EEST1/Entrenador4to2018/Documentación/2020/Principal.tex

\documentclass[a4paper,spanish]{article}
\usepackage{lmodern}
\renewcommand{\familydefault}{\sfdefault}
\usepackage[T1]{fontenc}
\usepackage[utf8]{inputenc}
\usepackage[spanish]{babel}
\setcounter{secnumdepth}{4}
\setcounter{tocdepth}{4}
\usepackage{array}
\usepackage{float}
\usepackage{fancybox}
\usepackage{calc}
\usepackage{units}
\usepackage{textcomp}
\usepackage{multirow}
\usepackage{amsmath}
\usepackage{amssymb}
\usepackage{graphicx}
\usepackage{nomencl}
\usepackage{fancyhdr}
\usepackage{graphics}
\usepackage{circuitikz}
\usepackage{pgf,tikz}
\usepackage{multicol,caption}
\usepackage{mathtools}
\usepackage[makeroom]{cancel}
\usepackage{lscape}
\usepackage{rotating}
\usepackage{lastpage}
\usepackage{titlesec}
\usepackage[margin=1in,headsep=1cm,headheight= 1in,top=1.5in]{geometry}
\usetikzlibrary{arrows}
\usetikzlibrary{shapes.symbols}
\usetikzlibrary{shapes.arrows}
\usetikzlibrary{calc,intersections,through,backgrounds}
\usetikzlibrary{patterns}
\PassOptionsToPackage{caption=false}{subfig}
\usepackage{subfig}
\makeatother
\graphicspath{ {imagenes/} }
\newtheorem{ej}{{Ejemplo }}[section]
\pagestyle{fancy}

\titleformat{name=\section}[block]
{\sffamily\bfseries\Large}
{}
{0pt}
{\colorsection}
\titlespacing*{\section}{0pt}{\baselineskip}{\baselineskip}

\newcommand{\colorsection}[1]{%
	\colorbox{teal!50}{\parbox{\dimexpr\textwidth-2\fboxsep}{\thesection\ #1}}}

\begin{document}

	\begin{tikzpicture}[remember picture, overlay]
	\node[at=(current page.center)](){};
	\node[overlay,anchor=south,yshift=4.5cm,fill=white](aplicaciones)at(current page.south)[]{\fontsize{40}{60} \textbf{ENTRENADOR DIGITAL}}		
	;
	%\node[below of=aplicaciones,yshift=-1 cm,fill=white](jaja){\fontsize{40}{50}\textbf{\emph{Profesor Esteban Lemos}}};
	\end{tikzpicture}
\clearpage
	%Indice automático
\fancyhead{}
\fancyhead[C]{ÍNDICE}

\tableofcontents{}
\clearpage
	%formato del resto del documento
\fancyhead{}

\rhead{\leftmark\\\rightmark}

\renewcommand{\footrulewidth}{2pt}
\renewcommand{\headrulewidth}{2pt}

\rfoot{\thepage\ of \pageref{LastPage}}
\fancyhead{}
\cfoot{\footnotesize\textbf{ Escuela de Educación Secundaria Técnica N$^\circ$ 1 - Vicente López}\\Cerrito N$^\circ$ 3966 (1605) Villa Adelina, Partido de Vicente López.\\Tel:(011) 47350174 -- email: tecnica1vl@gmail.com}

\lhead{\begin{tikzpicture}
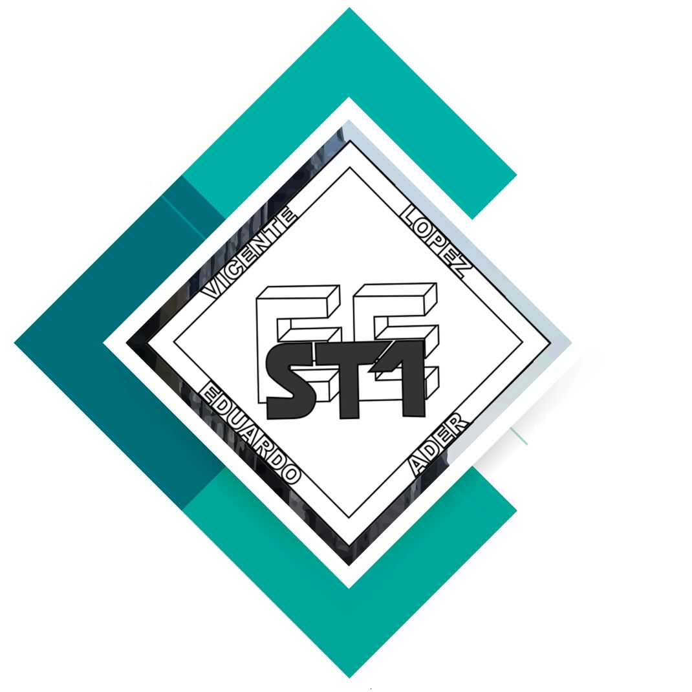
[picture p1: Documentación/2020/imagenes/logo2.jpg]
	\node (0,0)[]{};
	\node [text width=8cm,align=left,xshift=5cm] at (0,0){\textbf{Plan de Trabajo 2019}\linebreak Jefatura de Área\linebreak E.E.S.T. N$^\circ$ 1 V.L.} ;
	\end{tikzpicture}
}
\rhead{\leftmark\\\rightmark}

	%Contenidos
\include{Introduccion}	
\include{Armado}

%\include{PuestaEnMarcha}
%\include{Practicas}

\end{document}
