EEST1/Entrenador4to2018/Documentación/2020/imagenes/PosterBase-eps-converted-to.pdf

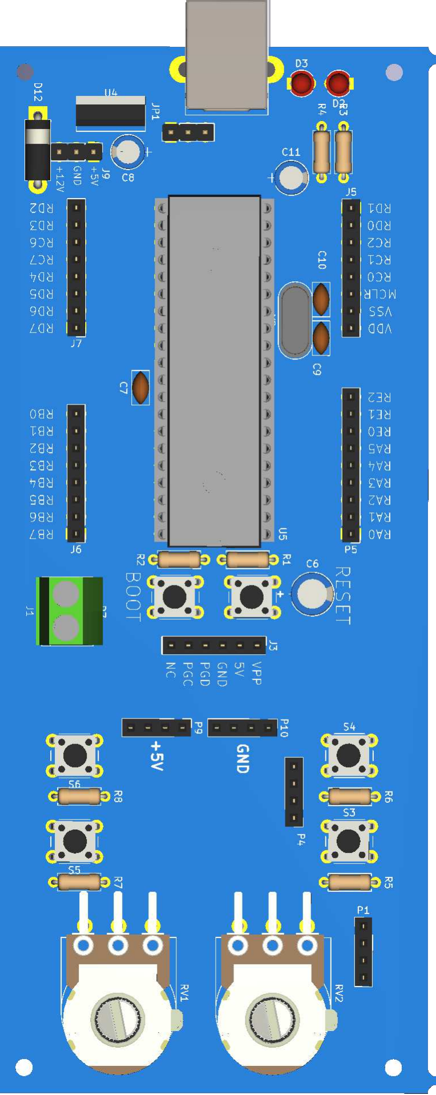
[picture p2: page 1]
