EEST1/Entrenador4to2018/Documentación/2020/imagenes/PosterBase.pdf

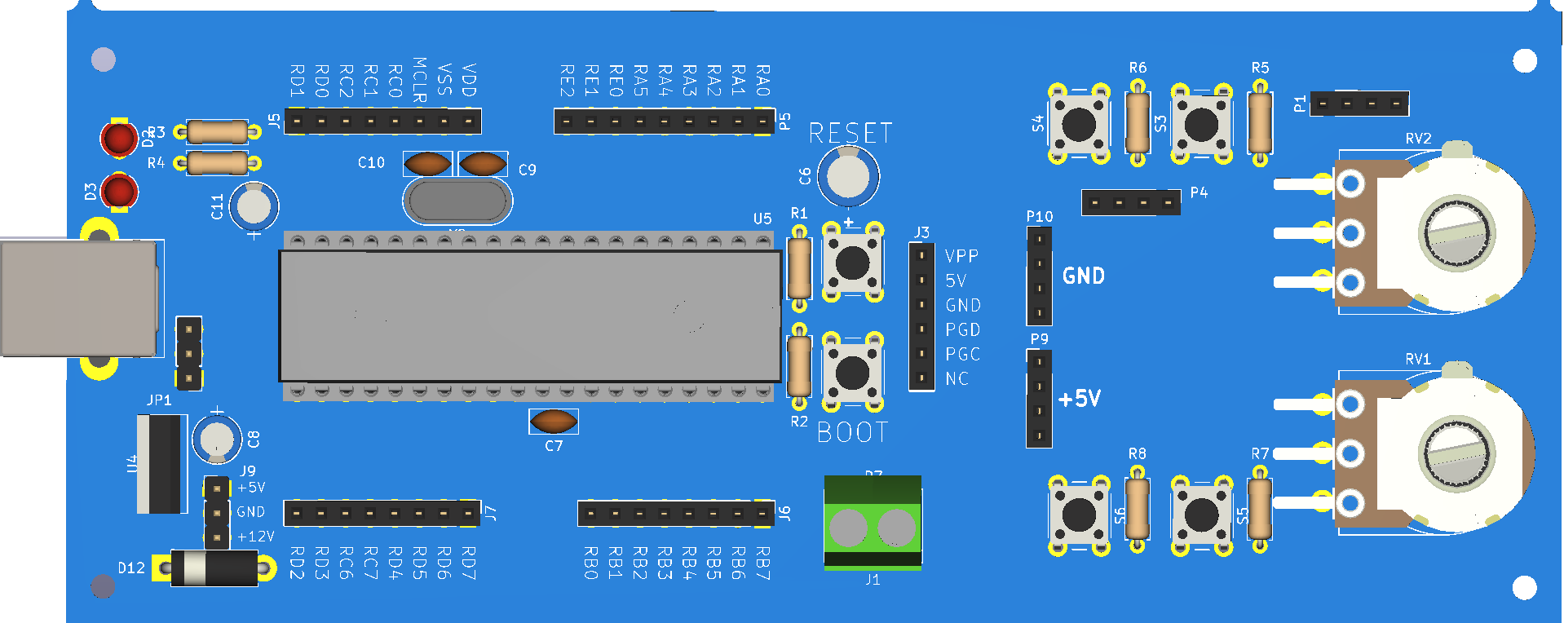
[picture p3: page 1]
