EEST1/Entrenador4to2018/Documentación/Gabinete.pdf

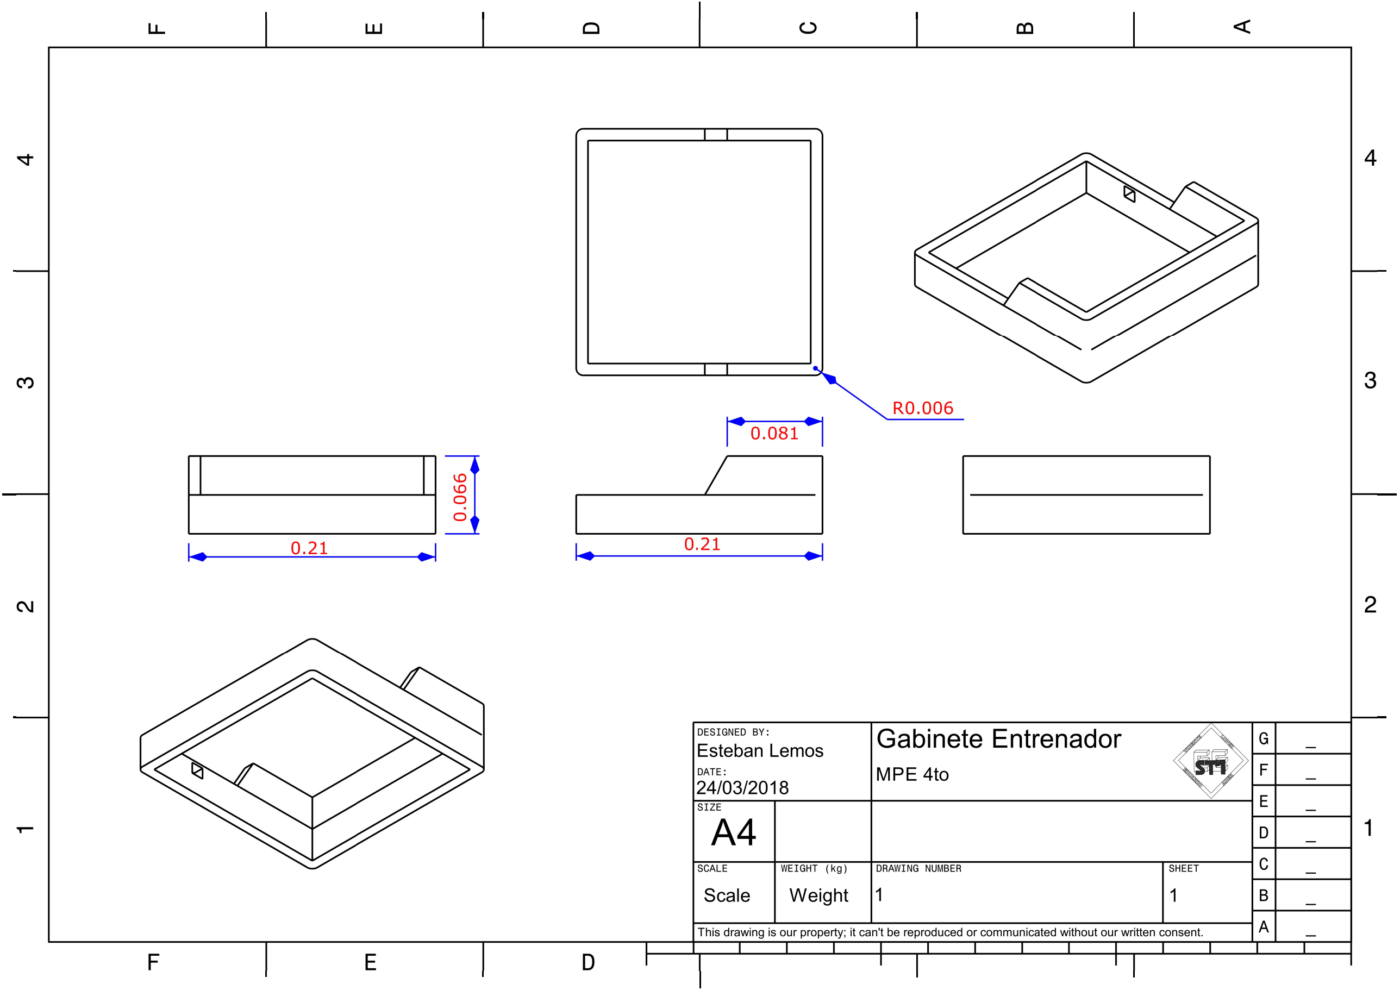
[picture p4: page 1]
