EEST1/Entrenador4to2018/Documentación/2020/imagenes/Esquematico.png

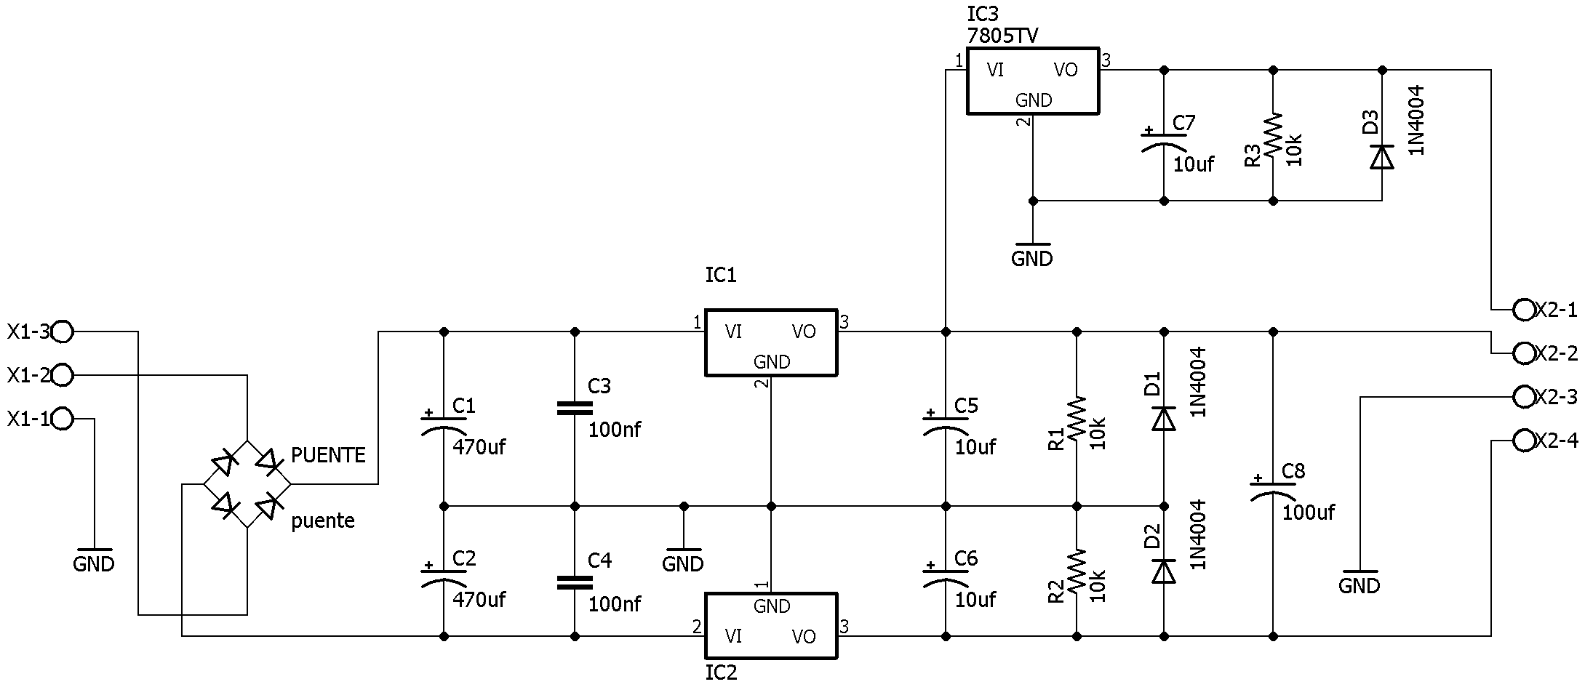
Documentación/2020/imagenes/Esquematico.png
