EEST1/Entrenador4to2018/Documentación/2020/imagenes/GabineteRender2.jpg

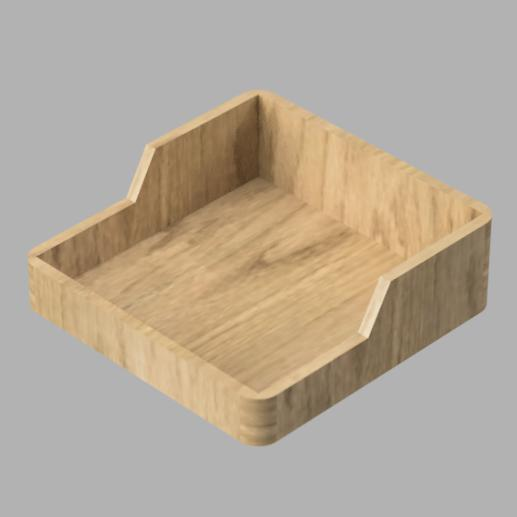
Documentación/2020/imagenes/GabineteRender2.jpg
