EEST1/Entrenador4to2018/Documentación/2020/imagenes/PosterCompletoEntrenador_2.png

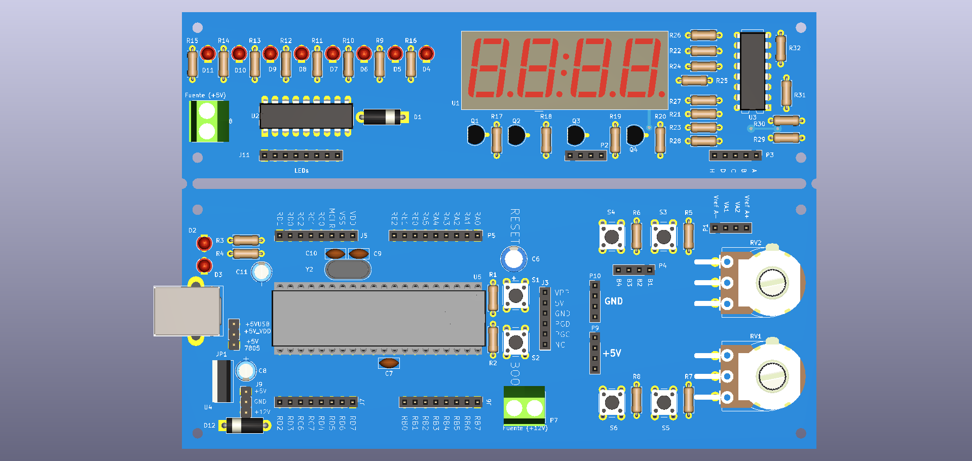
Documentación/2020/imagenes/PosterCompletoEntrenador_2.png
