EEST1/Entrenador4to2018/Documentación/Entrenador1-SchDoc_4Display_en_uno v13.jpg

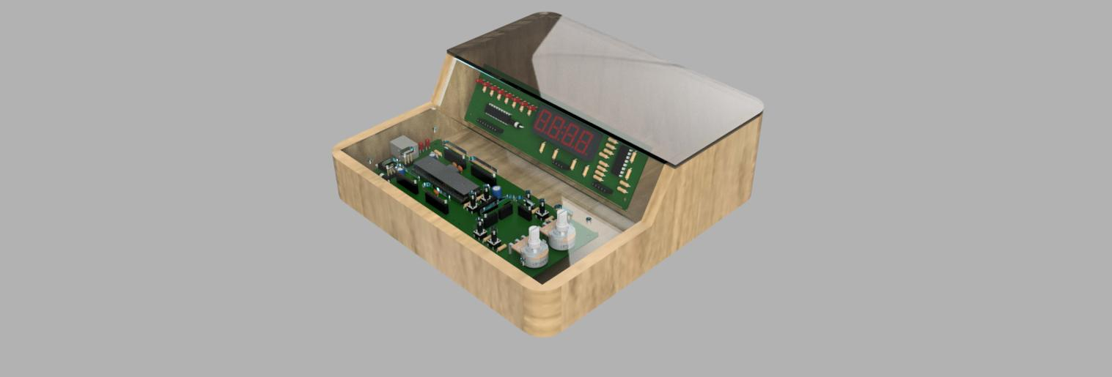
Documentación/Entrenador1-SchDoc_4Display_en_uno v13.jpg
