EEST1/Entrenador4to2018/Documentación/Entrenador1-SchDoc_4Display_en_uno v14.png

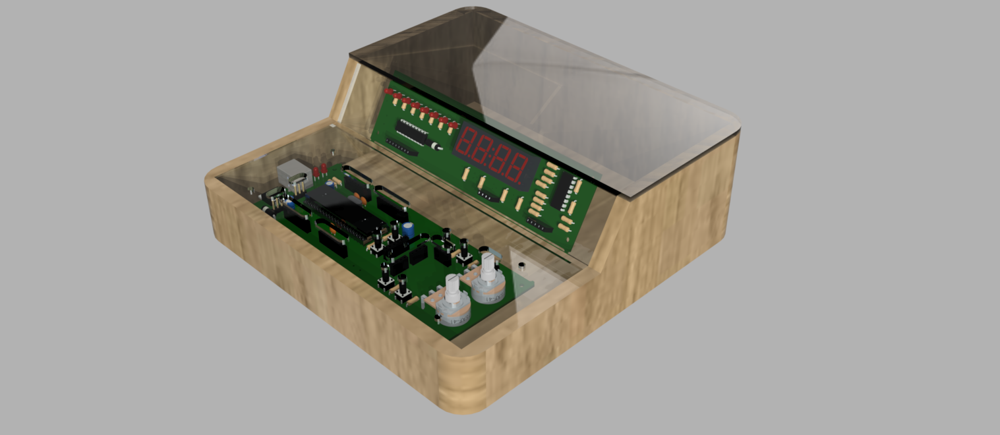
Documentación/Entrenador1-SchDoc_4Display_en_uno v14.png
