EEST1/Entrenador4to2018/Documentación/Entrenador1-SchDoc_4Display_en_uno_2020-Jan-02_07-53-40PM-000_CustomizedView2626504624_png_alpha.png

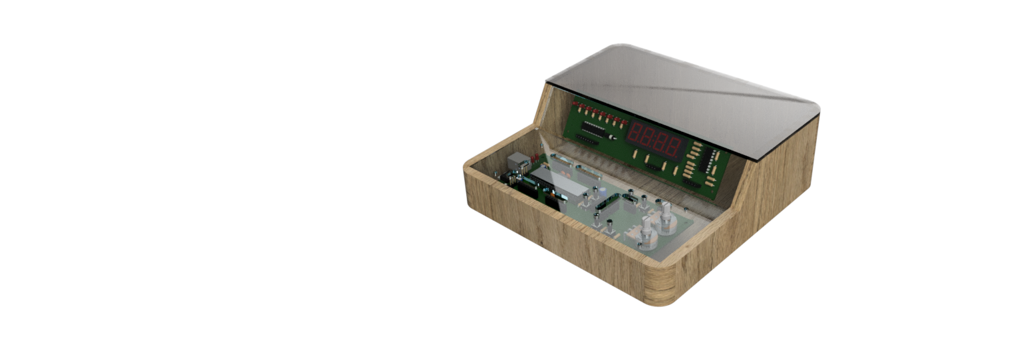
Documentación/Entrenador1-SchDoc_4Display_en_uno_2020-Jan-02_07-53-40PM-000_CustomizedView2626504624_png_alpha.png
