EEST1/Entrenador4to2018/Documentación/FB_IMG_1604214108332.jpg

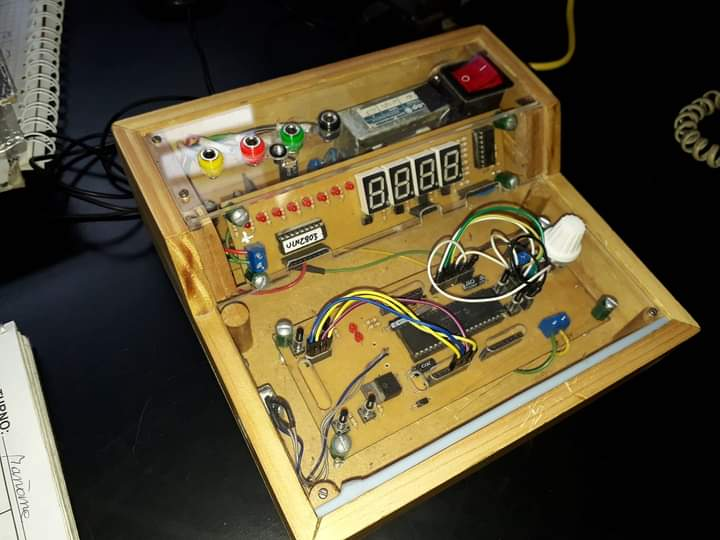
Documentación/FB_IMG_1604214108332.jpg
