EEST1/Entrenador4to2018/Modelos3d/4-different-switches-1.snapshot.2/untitled.165.jpg

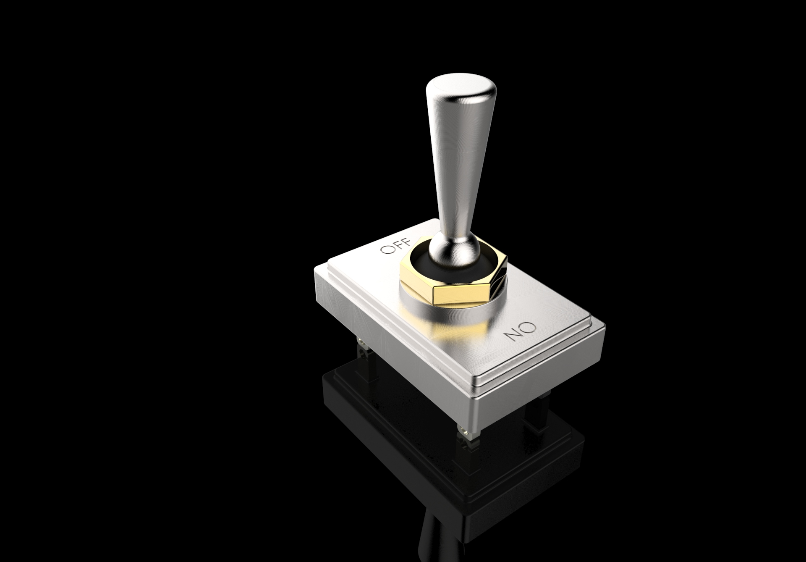
Modelos3d/4-different-switches-1.snapshot.2/untitled.165.jpg
