EEST1/Entrenador4to2018/Modelos3d/fuse-holder-8.snapshot.4/2017-11-11_21-51-52.jpg

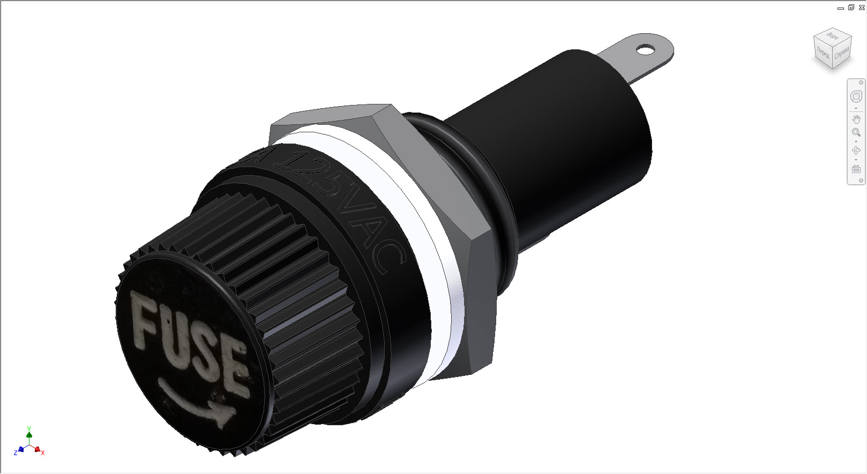
Modelos3d/fuse-holder-8.snapshot.4/2017-11-11_21-51-52.jpg
