EEST1/Entrenador4to2018/Modelos3d/fuse-holder-8.snapshot.4/IMG_20171111_112237.jpg

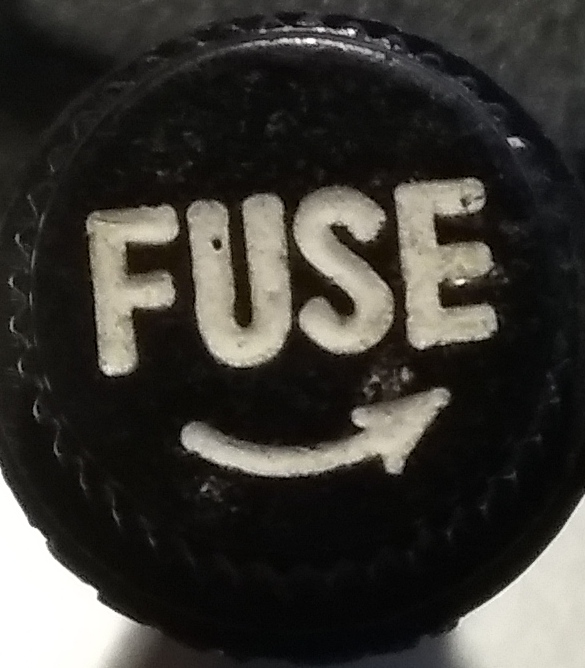
Modelos3d/fuse-holder-8.snapshot.4/IMG_20171111_112237.jpg
