EEST1/Entrenador4to2018/Modelos3d/hirschmann-pki-10-a-banana-plug-1.snapshot.2/Hirschmann PKI 10 A Banana plug v15.png

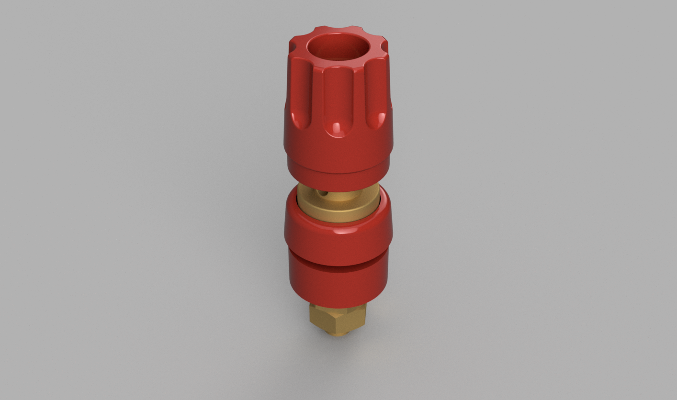
Modelos3d/hirschmann-pki-10-a-banana-plug-1.snapshot.2/Hirschmann PKI 10 A Banana plug v15.png
