EEST1/Entrenador4to2018/Documentación/Lista_Materiales.ods

Id | Cantidad | Identificador | Empaquetado | Identificación
1 | 1 | P6 | USB_B | USB_B
2 | 2 | P7,P8 | TerminalBlock_Altech_AK300-2_P5.00mm | CONN_01X02
3 | 1 | P5 | Socket_Strip_Straight_1x09_Pitch2.54mm | CONN_01X09
4 | 1 | JP1 | Pin_Header_Straight_1x03_Pitch2.54mm | JUMPER3
5 | 2 | D12,D1 | D_5W_P10.16mm_Horizontal | 1n4004
6 | 1 | J9 | Pin_Header_Straight_1x03_Pitch2.54mm | 3vias
7 | 5 | P1,P4,P9,P10,P2 | Socket_Strip_Straight_1x04_Pitch2.54mm | CONN_01X04
8 | 1 | Y2 | Crystal_HC49-4H_Vertical | 20MHz
9 | 2 | C10,C9 | C_Disc_D5.0mm_W2.5mm_P2.50mm | 22pf
10 | 1 | C8 | CP_Radial_D5.0mm_P2.50mm | 47uf
11 | 1 | C11 | CP_Radial_D5.0mm_P2.50mm | 1uf
12 | 1 | C6 | CP_Radial_D6.3mm_P2.50mm | 10uf
13 | 1 | J3 | Socket_Strip_Straight_1x06_Pitch2.54mm | ICSP
14 | 6 | S1,S2,S6,S5,S4,S3 | SW_PUSH_6mm_h13mm | SW DPST_2
15 | 10 | D11,D3,D2,D10,D9,D8,D7,D6,D5,D4 | LED_D3.0mm | LED
16 | 4 | J11,J5,J6,J7 | Socket_Strip_Straight_1x08_Pitch2.54mm | CON8
17 | 6 | R8,R2,R1,R7,R5,R6 | R_Axial_DIN0207_L6.3mm_D2.5mm_P7.62mm_Horizontal | 10K
18 | 16 | R15,R16,R13,R12,R11,R10,R9,R21,R22,R23,R24,R25,R26,R27,R28,R14 | R_Axial_DIN0207_L6.3mm_D2.5mm_P7.62mm_Horizontal | 180
19 | 2 | R4,R3 | R_Axial_DIN0207_L6.3mm_D2.5mm_P7.62mm_Horizontal | 470
20 | 4 | R18,R17,R19,R20 | R_Axial_DIN0207_L6.3mm_D2.5mm_P7.62mm_Horizontal | 1200
21 | 4 | R29,R30,R31,R32 | R_Axial_DIN0207_L6.3mm_D2.5mm_P7.62mm_Horizontal | 10k
22 | 1 | U5 | DIP-40_W15.24mm_LongPads | PIC18(L)F4550-I/P
23 | 1 | U4 | TO-220-3_Vertical | LM7805
24 | 1 | U3 | DIP-16_W7.62mm | 4511
25 | 1 | U2 | DIP-18_W7.62mm_LongPads | ULN2803
26 | 2 | RV2,RV1 | Potentiometer_Omeg_PC16PU_Horizontal | 10K lin
27 | 4 | AFF3,AFF2,AFF1,AFF4 | 7SegmentLED_LTS6760_LTS6780 | 7SEGMENTS
28 | 1 | C7 | C_Disc_D5.0mm_W2.5mm_P2.50mm | 100nf
29 | 4 | Q1,Q2,Q3,Q4 | TO-92_Molded_Narrow | BC548
30 | 1 | P3 | Socket_Strip_Straight_1x05_Pitch2.54mm | CONN_01X05
