EEST1/Entrenador4to2018/Base.FCStd

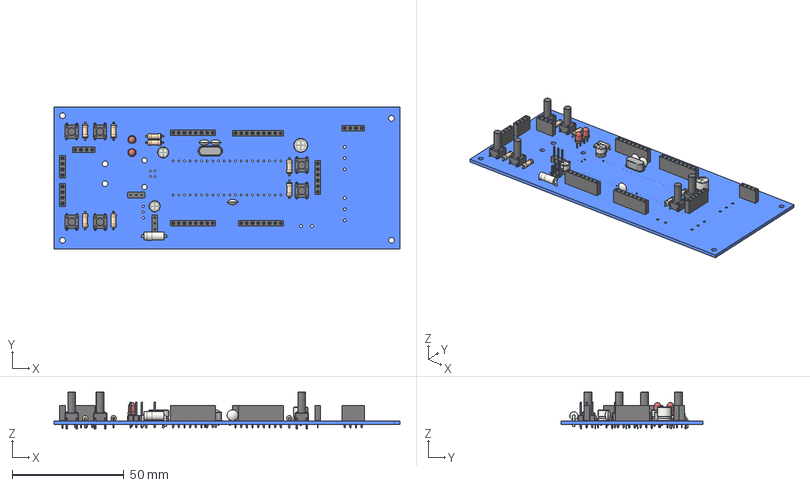
[picture p26: CAD file, 2018-02-24]
Base.FCStd
154.9 x 63.5 x 16.5 mm
Pcb
PinSocket_1x09_P254mm_Vertical_
PinHeader_1x03_P254mm_Vertical_
D_5W_P10.16mm_Horizontal_
PinHeader_1x03_P254mm_Vertical_001
PinSocket_1x04_P254mm_Vertical_
PinSocket_1x04_P254mm_Vertical_001
PinSocket_1x04_P254mm_Vertical_002
PinSocket_1x04_P254mm_Vertical_003
Crystal_HC49-4H_Vertical_
C_Disc_D50mm_W25mm_P250mm_
C_Disc_D50mm_W25mm_P250mm_001
CP_Radial_D50mm_P250mm_
CP_Radial_D50mm_P250mm_001
CP_Radial_D63mm_P250mm_
PinSocket_1x06_P254mm_Vertical_
SW_PUSH_6mm_h13mm_
SW_PUSH_6mm_h13mm_001
SW_PUSH_6mm_h13mm_002
SW_PUSH_6mm_h13mm_003
SW_PUSH_6mm_h13mm_004
SW_PUSH_6mm_h13mm_005
LED_D3.0mm_
LED_D3.0mm_001
PinSocket_1x08_P254mm_Vertical_
PinSocket_1x08_P254mm_Vertical_001
R_Axial_DIN0207_L63mm_D25mm_P762mm_Horizontal_
R_Axial_DIN0207_L63mm_D25mm_P762mm_Horizontal_001
R_Axial_DIN0207_L63mm_D25mm_P762mm_Horizontal_002
R_Axial_DIN0207_L63mm_D25mm_P762mm_Horizontal_003
R_Axial_DIN0207_L63mm_D25mm_P762mm_Horizontal_004
R_Axial_DIN0207_L63mm_D25mm_P762mm_Horizontal_005
R_Axial_DIN0207_L63mm_D25mm_P762mm_Horizontal_006
R_Axial_DIN0207_L63mm_D25mm_P762mm_Horizontal_007
C_Disc_D50mm_W25mm_P250mm_002
PinSocket_1x08_P254mm_Vertical_002
