EEST1/Entrenador4to2018/Gabinete2/basenameplate.stl

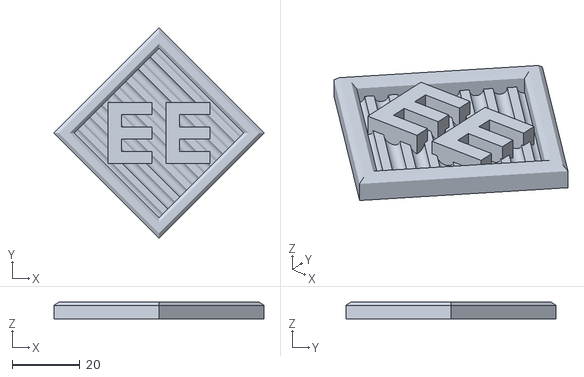
[picture p27: CAD file, 2019-06-22]
Gabinete2/basenameplate.stl
62.0 x 62.0 x 5.00
