EEST1/Entrenador4to2018/Modelos3d/4-different-switches-1.snapshot.2/Part4.STEP

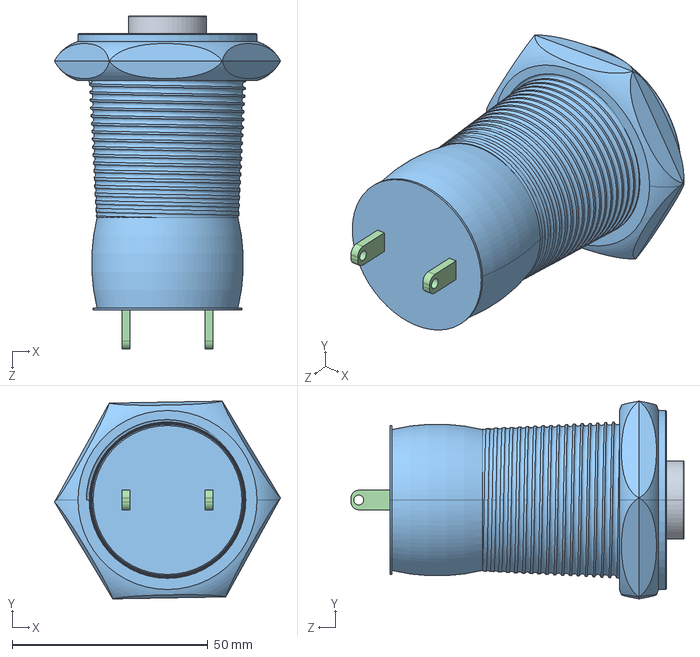
[picture p28: CAD file, 2018-02-05]
Modelos3d/4-different-switches-1.snapshot.2/Part4.STEP
57.7 x 50.5 x 85.0 mm
