EEST1/Entrenador4to2018/Modelos3d/hirschmann-pki-10-a-banana-plug-1.snapshot.2/Hirschmann PKI 10 A Banana plug v16.step

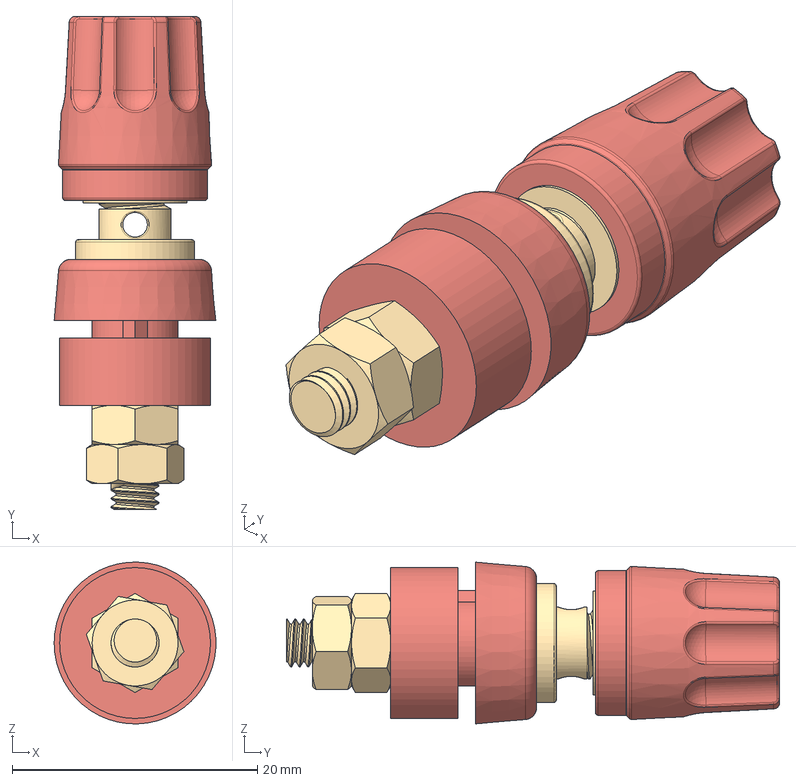
[picture p29: CAD file, 2018-02-05]
Modelos3d/hirschmann-pki-10-a-banana-plug-1.snapshot.2/Hirschmann PKI 10 A Banana plug v16.step
13.2 x 40.2 x 13.2 mm
Nut
Washer outside
Washer Inside
Brass
Metric Hex Nut
Metric Hex Nut (1)
