EEST1/Entrenador4to2018/Modelos3d/led_display_lts-547ag-1.snapshot.3/LED_Display_LTS-547AG.step

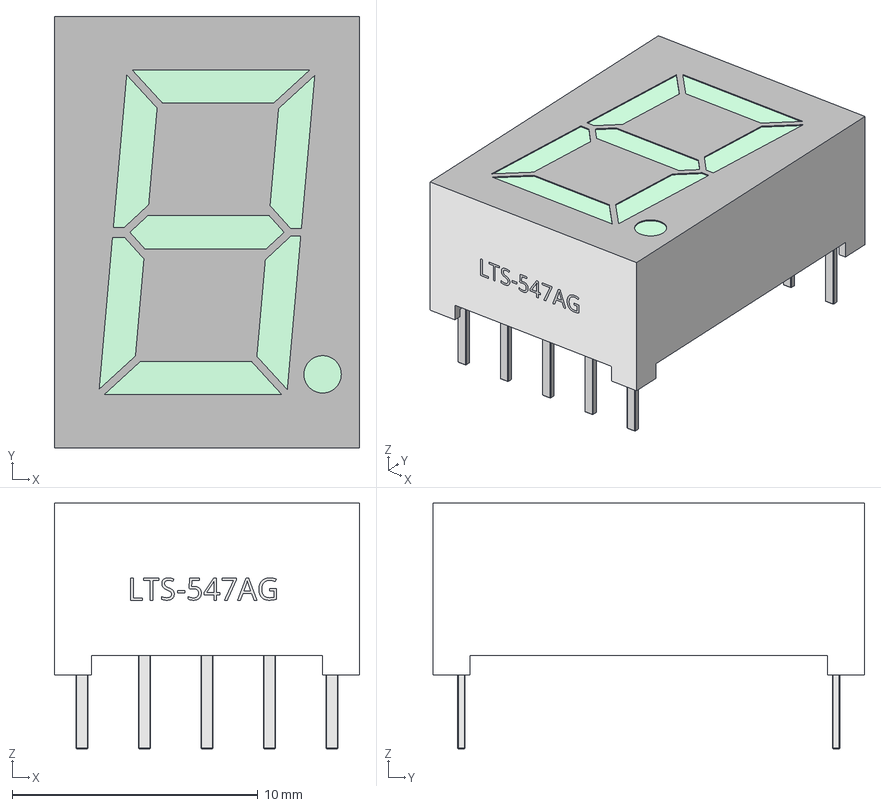
[picture p30: CAD file, 2018-02-05]
Modelos3d/led_display_lts-547ag-1.snapshot.3/LED_Display_LTS-547AG.step
12.4 x 17.6 x 10.0 mm
ShapeString
Broches1_10
Avant_les_broches
