EEST1/Entrenador4to2018/Modelos3d/PinSocket_1x05_P2.54mm_Vertical.step

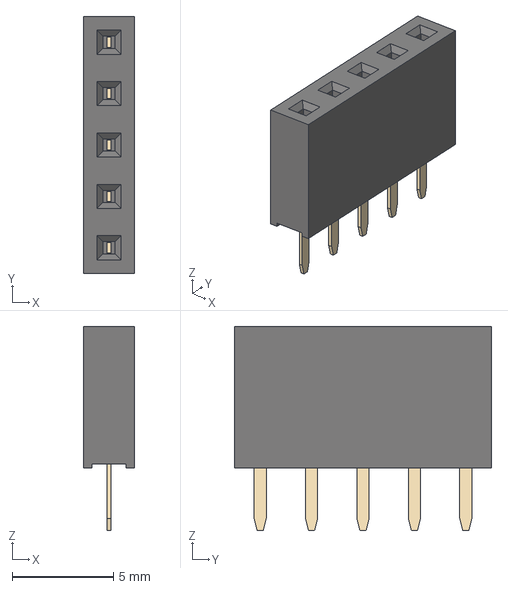
[picture p31: CAD file, 2018-02-14]
Modelos3d/PinSocket_1x05_P2.54mm_Vertical.step
2.54 x 12.7 x 10.1 mm
