EEST1/Entrenador4to2018/Modelos3d/potentiometer-rv16af-41-1.snapshot.2/potentiometer(RV16AF-41).STEP

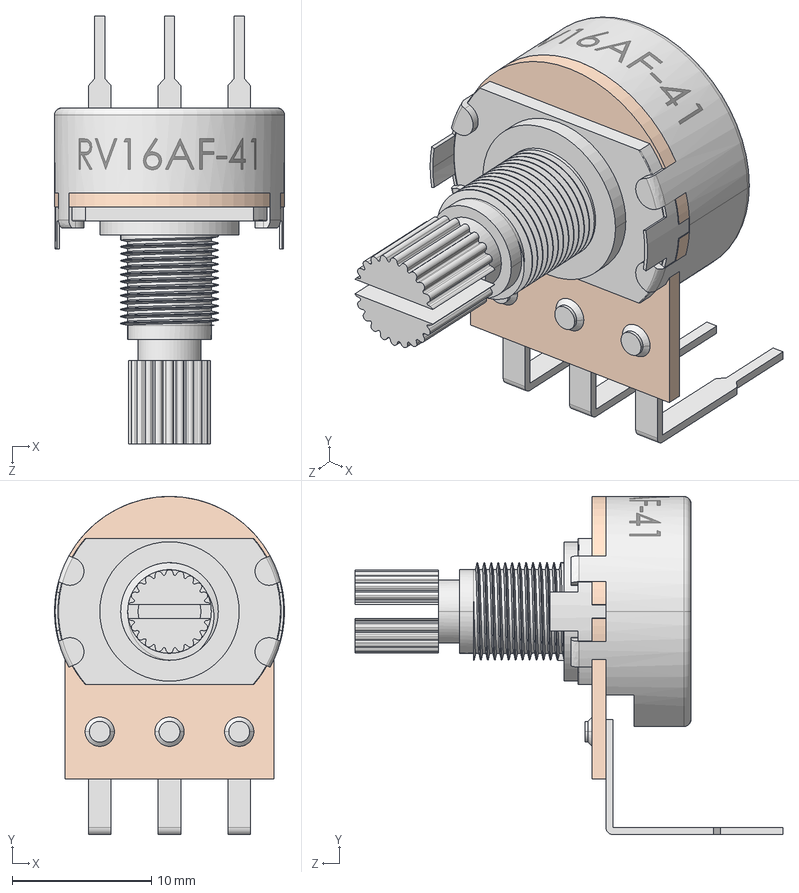
[picture p32: CAD file, 2020-01-16]
Modelos3d/potentiometer-rv16af-41-1.snapshot.2/potentiometer(RV16AF-41).STEP
16.5 x 24.2 x 30.7 mm
