EEST1/Entrenador4to2018/Frente1.step

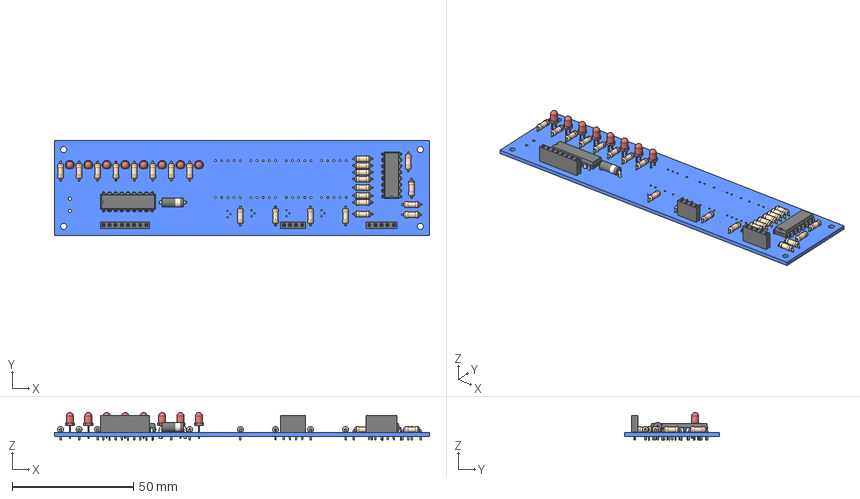
[picture p33: CAD file, 2018-02-14]
Frente1.step
154.9 x 39.4 x 11.6 mm
Pcb
LED_D3.0mm_
LED_D3.0mm_001
LED_D3.0mm_002
LED_D3.0mm_003
LED_D3.0mm_004
LED_D3.0mm_005
LED_D3.0mm_006
LED_D3.0mm_007
PinSocket_1x08_P254mm_Vertical_
R_Axial_DIN0207_L63mm_D25mm_P762mm_Horizontal_
R_Axial_DIN0207_L63mm_D25mm_P762mm_Horizontal_001
R_Axial_DIN0207_L63mm_D25mm_P762mm_Horizontal_002
R_Axial_DIN0207_L63mm_D25mm_P762mm_Horizontal_003
R_Axial_DIN0207_L63mm_D25mm_P762mm_Horizontal_004
R_Axial_DIN0207_L63mm_D25mm_P762mm_Horizontal_005
R_Axial_DIN0207_L63mm_D25mm_P762mm_Horizontal_006
R_Axial_DIN0207_L63mm_D25mm_P762mm_Horizontal_007
R_Axial_DIN0207_L63mm_D25mm_P762mm_Horizontal_008
R_Axial_DIN0207_L63mm_D25mm_P762mm_Horizontal_009
R_Axial_DIN0207_L63mm_D25mm_P762mm_Horizontal_010
R_Axial_DIN0207_L63mm_D25mm_P762mm_Horizontal_011
R_Axial_DIN0207_L63mm_D25mm_P762mm_Horizontal_012
R_Axial_DIN0207_L63mm_D25mm_P762mm_Horizontal_013
R_Axial_DIN0207_L63mm_D25mm_P762mm_Horizontal_014
R_Axial_DIN0207_L63mm_D25mm_P762mm_Horizontal_015
R_Axial_DIN0207_L63mm_D25mm_P762mm_Horizontal_016
R_Axial_DIN0207_L63mm_D25mm_P762mm_Horizontal_017
R_Axial_DIN0207_L63mm_D25mm_P762mm_Horizontal_018
R_Axial_DIN0207_L63mm_D25mm_P762mm_Horizontal_019
R_Axial_DIN0207_L63mm_D25mm_P762mm_Horizontal_020
R_Axial_DIN0207_L63mm_D25mm_P762mm_Horizontal_021
R_Axial_DIN0207_L63mm_D25mm_P762mm_Horizontal_022
R_Axial_DIN0207_L63mm_D25mm_P762mm_Horizontal_023
PinSocket_1x04_P254mm_Vertical_
D_5W_P10.16mm_Horizontal_
PinSocket_1x05_P254mm_Vertical_
DIP-16_W7.62mm_
DIP-18_W7.62mm_
