EEST1/Entrenador4to2018/Gabinete2/letrabordes.stl

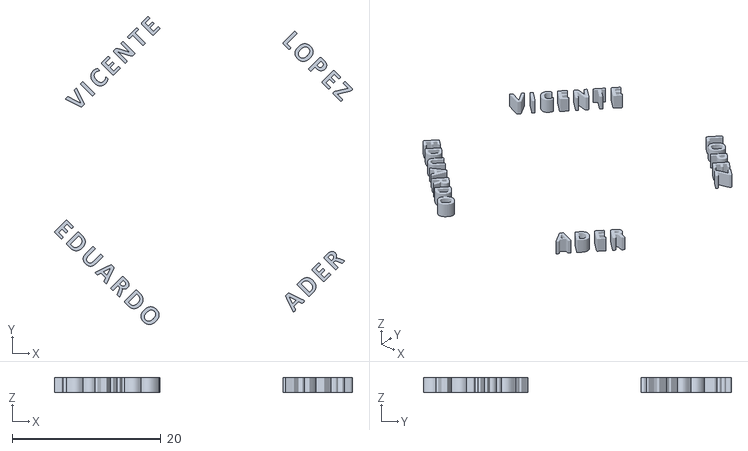
[picture p34: CAD file, 2019-06-22]
Gabinete2/letrabordes.stl
40.0 x 41.4 x 2.00
