EEST1/Entrenador4to2018/Modelos3d/4-different-switches-1.snapshot.2/Part2.STEP

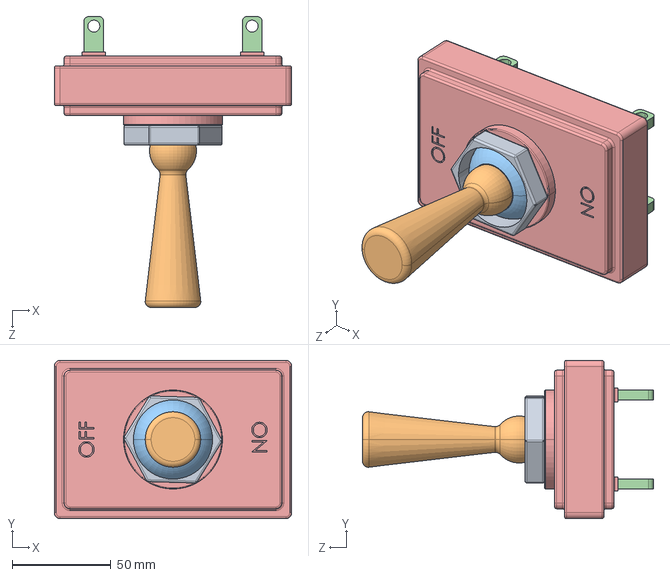
[picture p35: CAD file, 2018-02-05]
Modelos3d/4-different-switches-1.snapshot.2/Part2.STEP
120.0 x 80.0 x 147.0 mm
