EEST1/Entrenador4to2018/Modelos3d/DIP-16_W7.62mm.step

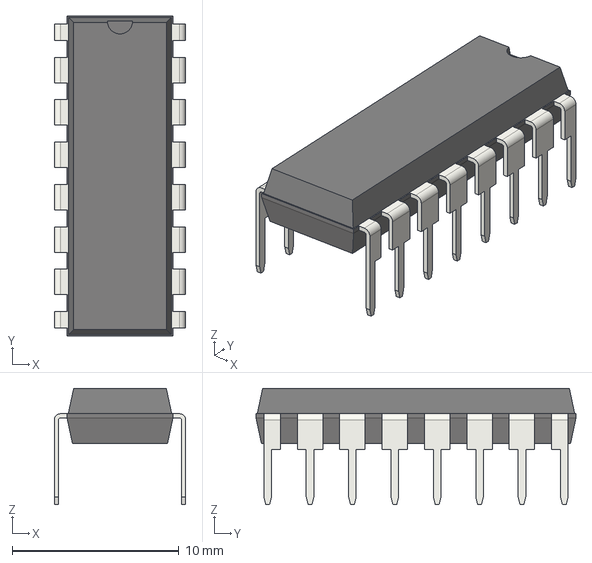
[picture p36: CAD file, 2018-02-14]
Modelos3d/DIP-16_W7.62mm.step
7.87 x 19.2 x 6.98 mm
