EEST1/Entrenador4to2018/Gabinete2/letranegranameplate.stl

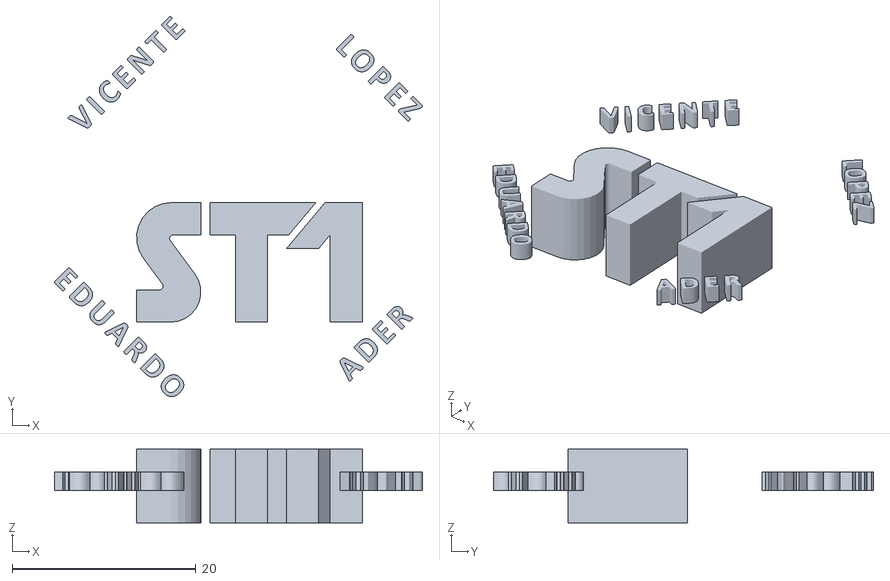
[picture p37: CAD file, 2019-06-22]
Gabinete2/letranegranameplate.stl
40.0 x 41.4 x 8.00
