EEST1/Entrenador4to2018/Modelos3d/4-different-switches-1.snapshot.2/Part1.STEP

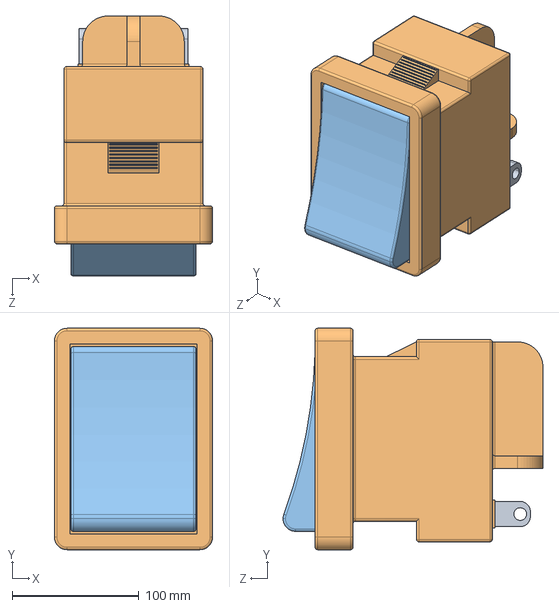
[picture p38: CAD file, 2018-02-05]
Modelos3d/4-different-switches-1.snapshot.2/Part1.STEP
125.0 x 175.0 x 205.4 mm
