EEST1/Entrenador4to2018/Modelos3d/DIP-18_W7.62mm.step

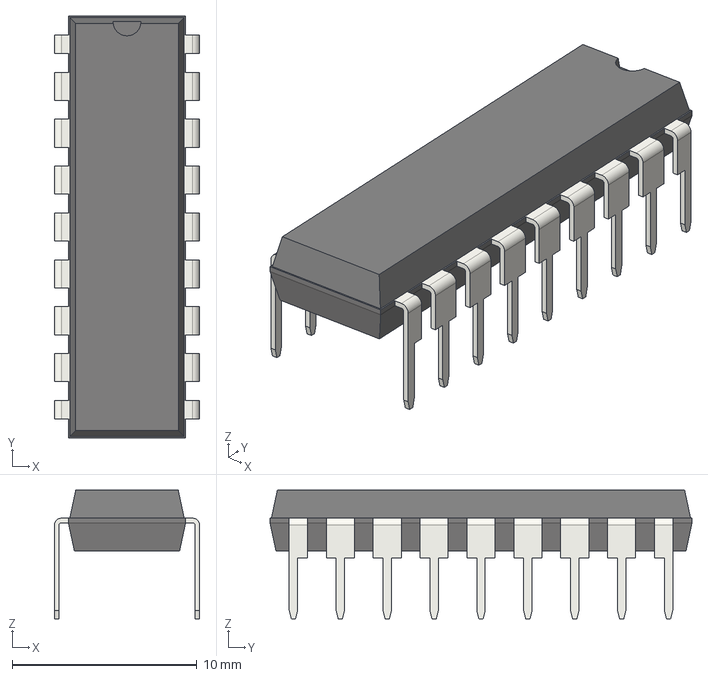
[picture p39: CAD file, 2018-02-14]
Modelos3d/DIP-18_W7.62mm.step
7.87 x 22.9 x 6.98 mm
