EEST1/Entrenador4to2018/Entrenador1_SchDoc.FCStd

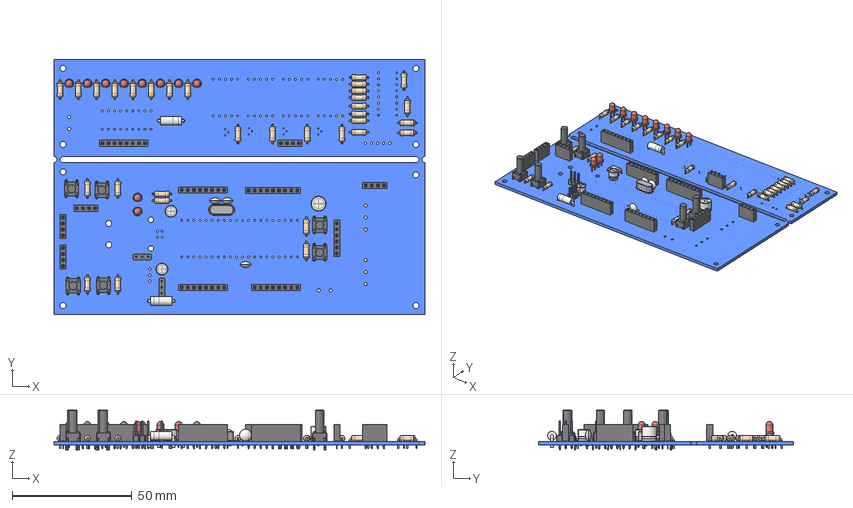
[picture p40: CAD file, 2018-02-14]
Entrenador1_SchDoc.FCStd
154.9 x 106.7 x 16.5 mm
Pcb
PinSocket_1x09_P254mm_Vertical_
PinHeader_1x03_P254mm_Vertical_
D_5W_P10.16mm_Horizontal_
PinHeader_1x03_P254mm_Vertical_001
PinSocket_1x04_P254mm_Vertical_
PinSocket_1x04_P254mm_Vertical_001
PinSocket_1x04_P254mm_Vertical_002
PinSocket_1x04_P254mm_Vertical_003
Crystal_HC49-4H_Vertical_
C_Disc_D50mm_W25mm_P250mm_
C_Disc_D50mm_W25mm_P250mm_001
CP_Radial_D50mm_P250mm_
CP_Radial_D50mm_P250mm_001
CP_Radial_D63mm_P250mm_
PinSocket_1x06_P254mm_Vertical_
SW_PUSH_6mm_h13mm_
SW_PUSH_6mm_h13mm_001
SW_PUSH_6mm_h13mm_002
SW_PUSH_6mm_h13mm_003
SW_PUSH_6mm_h13mm_004
SW_PUSH_6mm_h13mm_005
LED_D3.0mm_
LED_D3.0mm_001
LED_D3.0mm_002
LED_D3.0mm_003
LED_D3.0mm_004
LED_D3.0mm_005
LED_D3.0mm_006
LED_D3.0mm_007
LED_D3.0mm_008
LED_D3.0mm_009
PinSocket_1x08_P254mm_Vertical_
PinSocket_1x08_P254mm_Vertical_001
PinSocket_1x08_P254mm_Vertical_002
R_Axial_DIN0207_L63mm_D25mm_P762mm_Horizontal_
R_Axial_DIN0207_L63mm_D25mm_P762mm_Horizontal_001
R_Axial_DIN0207_L63mm_D25mm_P762mm_Horizontal_002
R_Axial_DIN0207_L63mm_D25mm_P762mm_Horizontal_003
R_Axial_DIN0207_L63mm_D25mm_P762mm_Horizontal_004
R_Axial_DIN0207_L63mm_D25mm_P762mm_Horizontal_005
R_Axial_DIN0207_L63mm_D25mm_P762mm_Horizontal_006
R_Axial_DIN0207_L63mm_D25mm_P762mm_Horizontal_007
R_Axial_DIN0207_L63mm_D25mm_P762mm_Horizontal_008
R_Axial_DIN0207_L63mm_D25mm_P762mm_Horizontal_009
R_Axial_DIN0207_L63mm_D25mm_P762mm_Horizontal_010
R_Axial_DIN0207_L63mm_D25mm_P762mm_Horizontal_011
R_Axial_DIN0207_L63mm_D25mm_P762mm_Horizontal_012
R_Axial_DIN0207_L63mm_D25mm_P762mm_Horizontal_013
R_Axial_DIN0207_L63mm_D25mm_P762mm_Horizontal_014
R_Axial_DIN0207_L63mm_D25mm_P762mm_Horizontal_015
R_Axial_DIN0207_L63mm_D25mm_P762mm_Horizontal_016
R_Axial_DIN0207_L63mm_D25mm_P762mm_Horizontal_017
R_Axial_DIN0207_L63mm_D25mm_P762mm_Horizontal_018
R_Axial_DIN0207_L63mm_D25mm_P762mm_Horizontal_019
R_Axial_DIN0207_L63mm_D25mm_P762mm_Horizontal_020
R_Axial_DIN0207_L63mm_D25mm_P762mm_Horizontal_021
R_Axial_DIN0207_L63mm_D25mm_P762mm_Horizontal_022
R_Axial_DIN0207_L63mm_D25mm_P762mm_Horizontal_023
R_Axial_DIN0207_L63mm_D25mm_P762mm_Horizontal_024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
