EEST1/Entrenador4to2018/Gabinete2/Perilla.FCStd

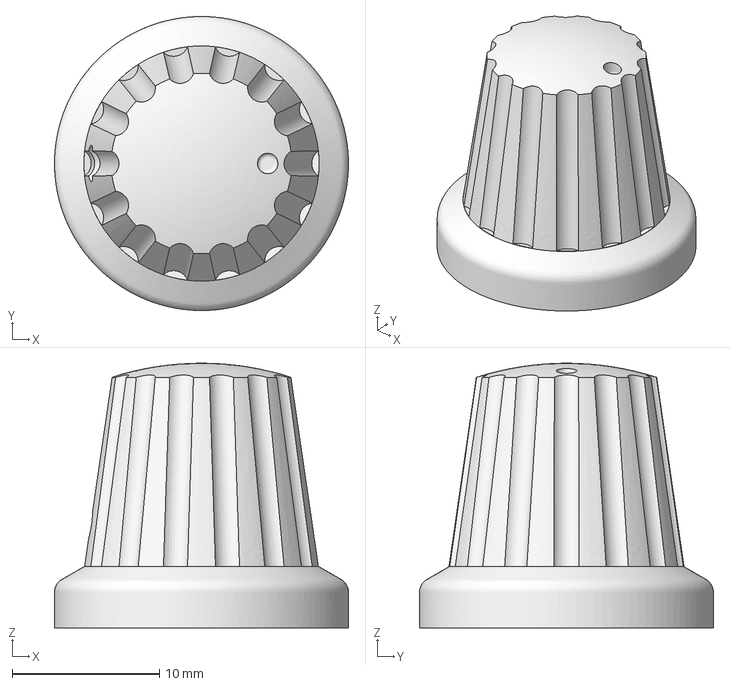
[picture p41: CAD file, 2018-11-20]
Gabinete2/Perilla.FCStd
20.0 x 20.0 x 18.0 mm
