EEST1/Entrenador4to2018/Modelos3d/4-different-switches-1.snapshot.2/Part3.STEP

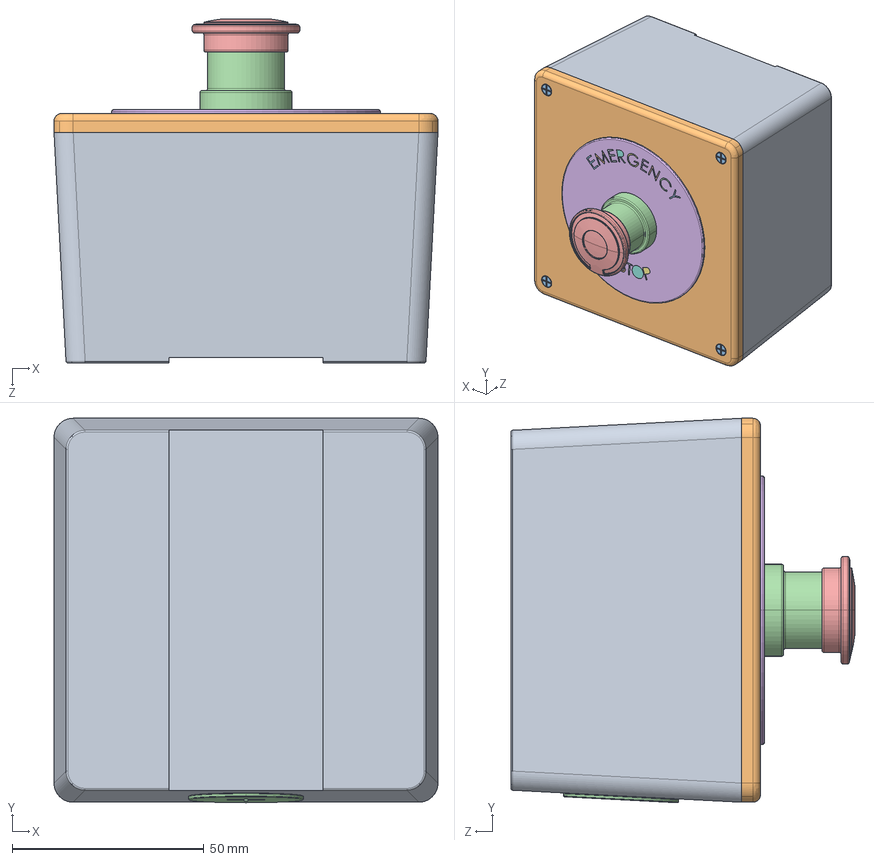
[picture p42: CAD file, 2018-02-05]
Modelos3d/4-different-switches-1.snapshot.2/Part3.STEP
100.0 x 100.1 x 89.6 mm
