EEST1/Entrenador4to2018/Modelos3d/DISPLAY 7SEG.STEP

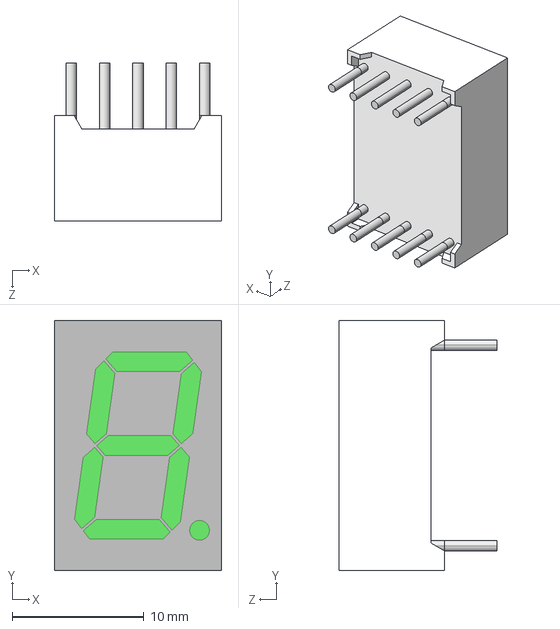
[picture p43: CAD file, 2018-02-05]
Modelos3d/DISPLAY 7SEG.STEP
12.7 x 19.0 x 12.0 mm
