EEST1/Entrenador4to2018/Modelos3d/9v_Transformer.step

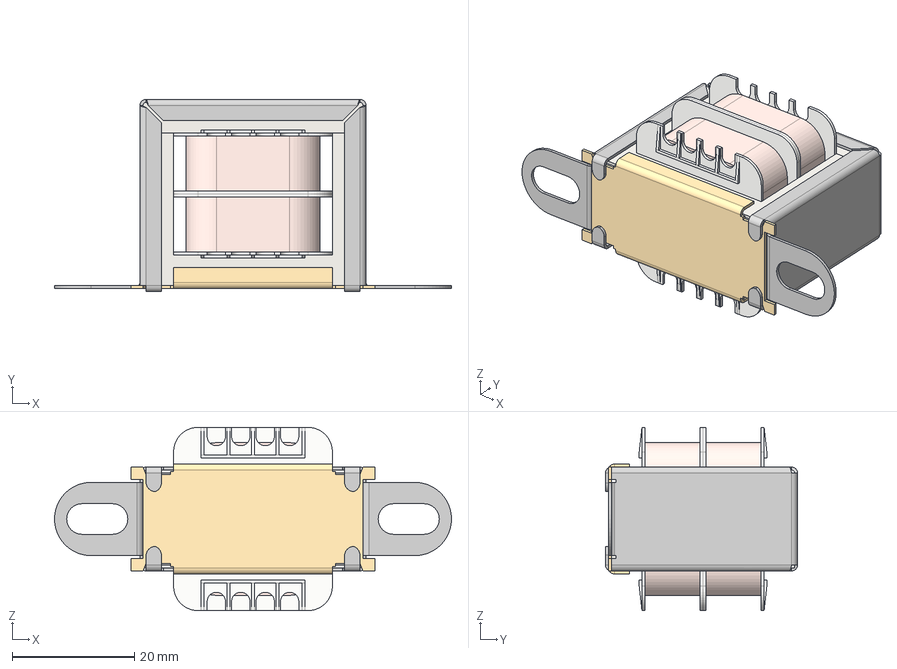
[picture p44: CAD file, 2018-02-05]
Modelos3d/9v_Transformer.step
65.0 x 31.5 x 30.0 mm
conductive_sheet x 32
base
Support
Washer
Washer (1)
Support (1)
Spiral x 2
