EEST1/Entrenador4to2018/Gabinete2/nameplate.FCStd

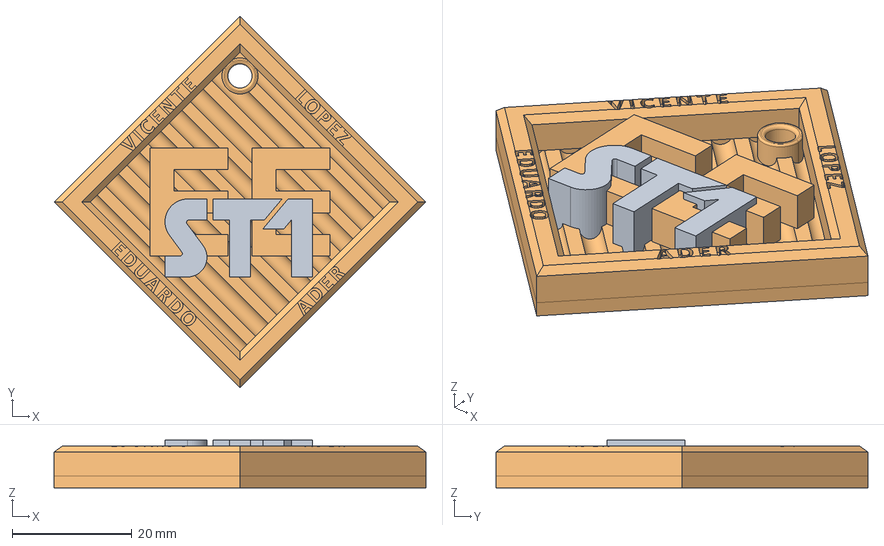
[picture p45: CAD file, 2018-11-19]
Gabinete2/nameplate.FCStd
62.0 x 62.0 x 8.00 mm
LetraNegra
BaseFinal
