EEST1/Entrenador4to2018/Modelos3d/C_Disc_D5.0mm_W2.5mm_P2.50mm.step

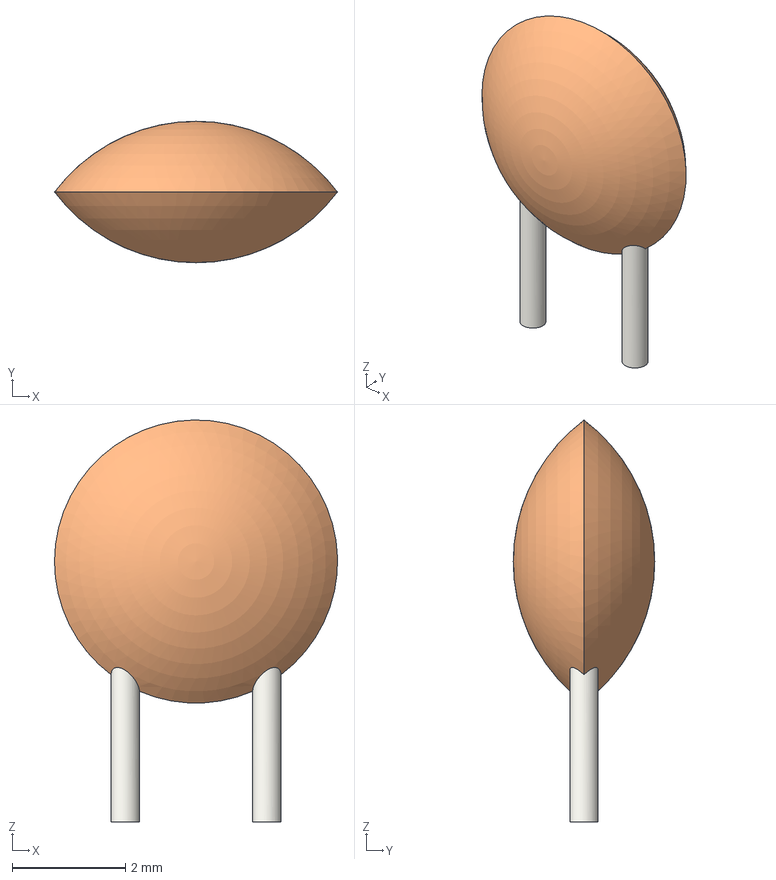
[picture p46: CAD file, 2018-02-05]
Modelos3d/C_Disc_D5.0mm_W2.5mm_P2.50mm.step
5.00 x 2.50 x 7.10 mm
