EEST1/Entrenador4to2018/Modelos3d/LED_D3.0mm.step

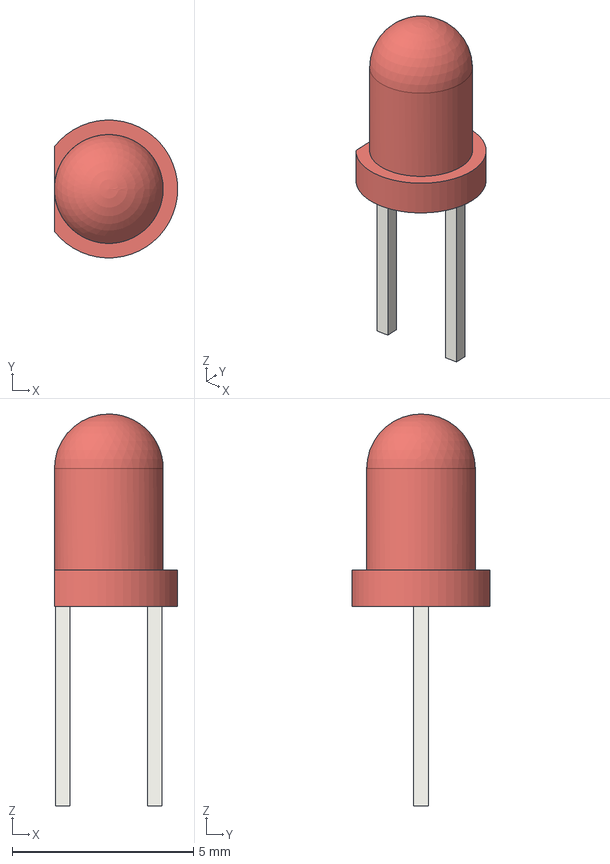
[picture p48: CAD file, 2018-02-05]
Modelos3d/LED_D3.0mm.step
3.40 x 3.80 x 10.8 mm
