EEST1/Entrenador4to2018/Modelos3d/CP_Radial_D6.3mm_P2.50mm.step

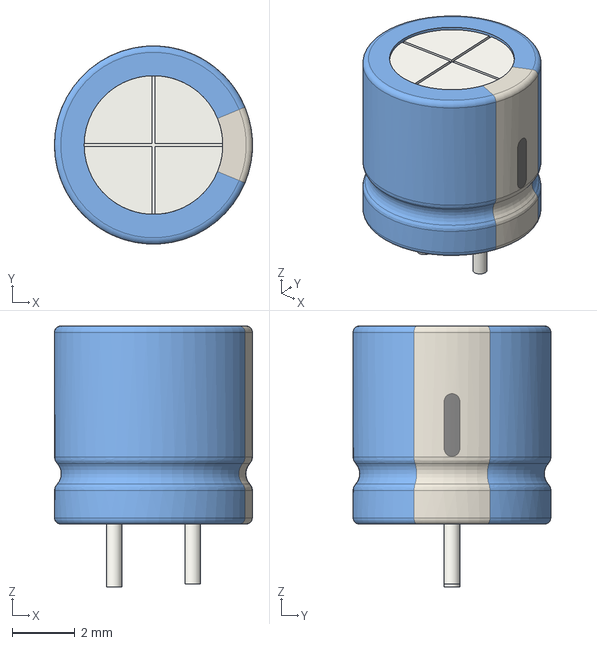
[picture p49: CAD file, 2018-02-05]
Modelos3d/CP_Radial_D6.3mm_P2.50mm.step
6.30 x 6.30 x 8.30 mm
