EEST1/Entrenador4to2018/Modelos3d/PinSocket_1x07_P2.54mm_Vertical.step

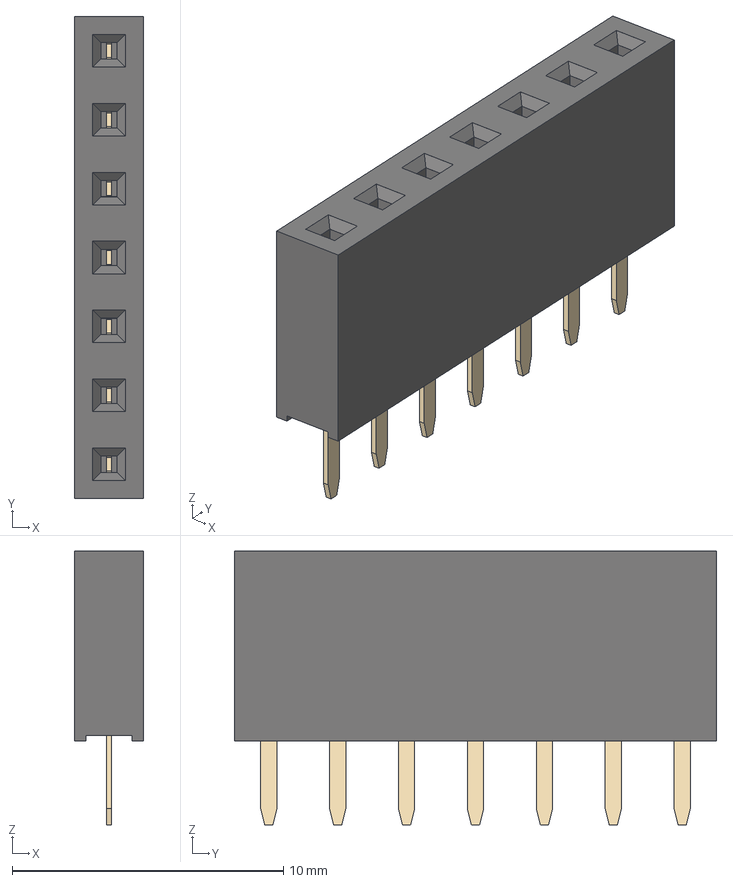
[picture p50: CAD file, 2018-02-05]
Modelos3d/PinSocket_1x07_P2.54mm_Vertical.step
2.54 x 17.8 x 10.1 mm
