EEST1/Entrenador4to2018/Modelos3d/usb_B.STEP

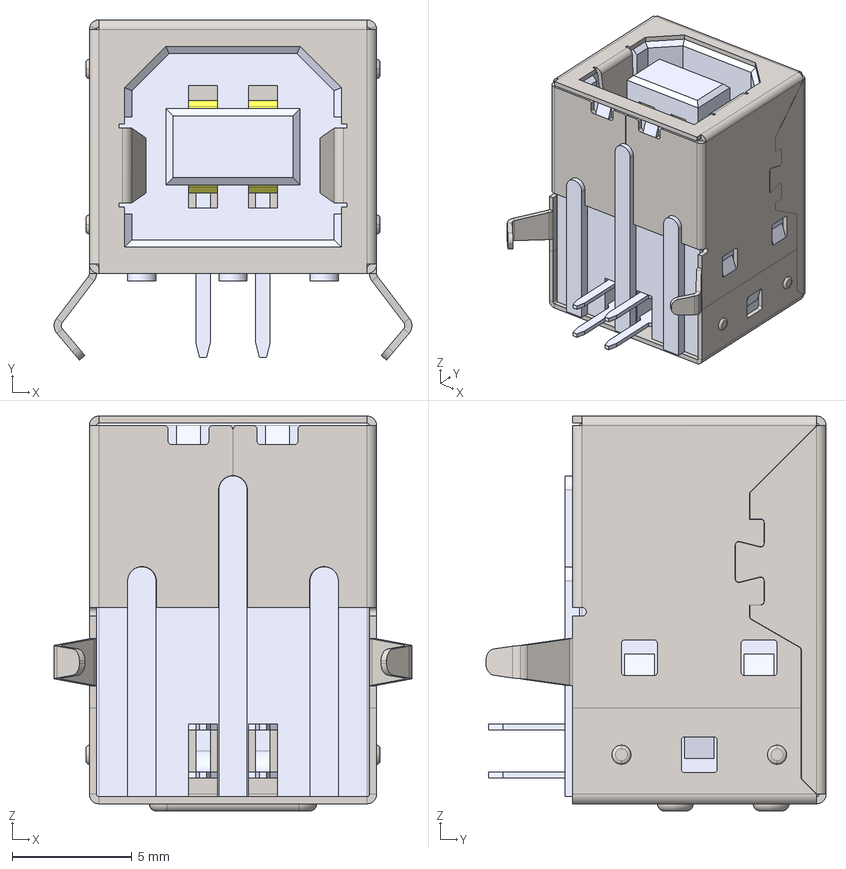
[picture p52: CAD file, 2018-02-05]
Modelos3d/usb_B.STEP
14.9 x 14.2 x 16.5 mm
