EEST1/Entrenador4to2018/Modelos3d/D_5W_P10.16mm_Horizontal.step

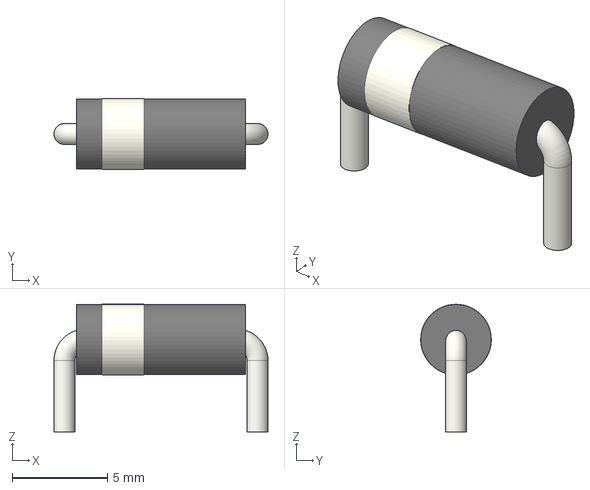
[picture p54: CAD file, 2018-02-05]
Modelos3d/D_5W_P10.16mm_Horizontal.step
11.3 x 3.72 x 6.71 mm
