EEST1/Entrenador4to2018/Modelos3d/BARREL_JACK.stl

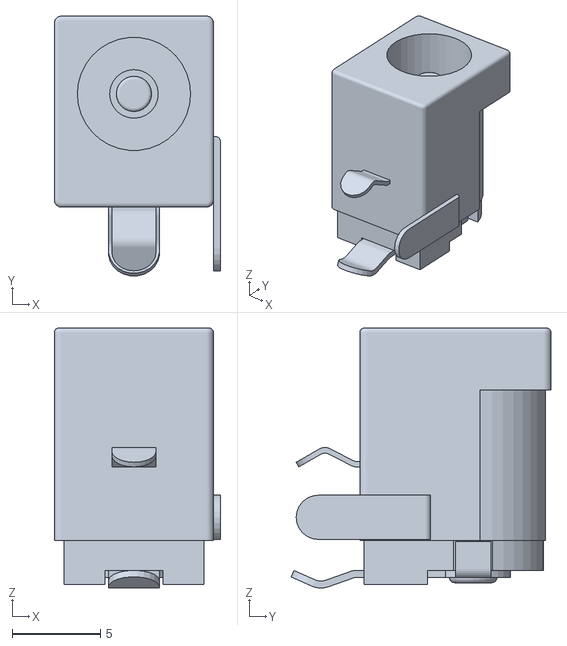
[picture p55: CAD file, 2018-02-05]
Modelos3d/BARREL_JACK.stl
9.40 x 14.7 x 14.7
