EEST1/Entrenador4to2018/Modelos3d/CP_Radial_D5.0mm_P2.50mm.step

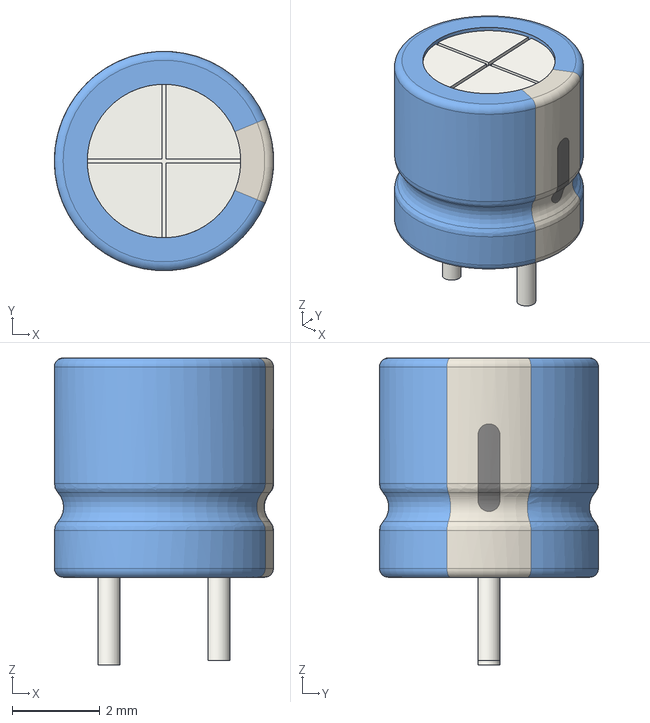
[picture p56: CAD file, 2018-02-05]
Modelos3d/CP_Radial_D5.0mm_P2.50mm.step
5.00 x 5.00 x 7.00 mm
