EEST1/Entrenador4to2018/Modelos3d/PinSocket_1x04_P2.54mm_Vertical.step

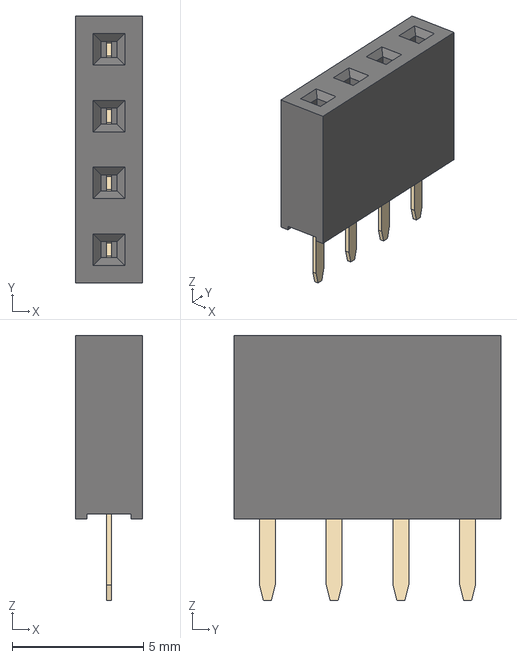
[picture p57: CAD file, 2018-02-05]
Modelos3d/PinSocket_1x04_P2.54mm_Vertical.step
2.54 x 10.2 x 10.1 mm
