EEST1/Entrenador4to2018/Modelos3d/SW_PUSH_6mm_h13mm.step

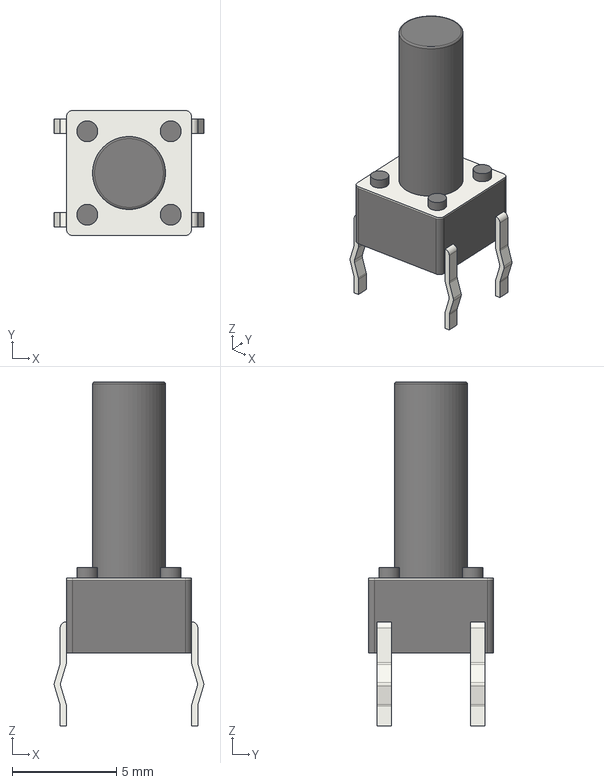
[picture p58: CAD file, 2018-02-05]
Modelos3d/SW_PUSH_6mm_h13mm.step
7.17 x 6.00 x 16.5 mm
