EEST1/Entrenador4to2018/Modelos3d/Crystal_HC49-4H_Vertical.step

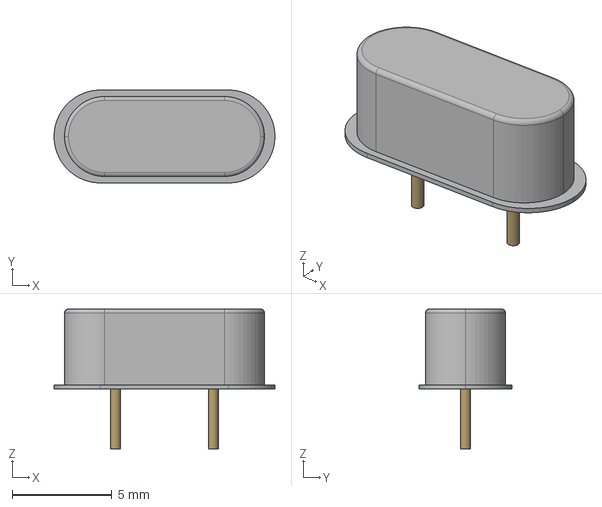
[picture p61: CAD file, 2018-02-05]
Modelos3d/Crystal_HC49-4H_Vertical.step
11.1 x 4.65 x 7.00 mm
