EEST1/Entrenador4to2018/Modelos3d/PinHeader_1x03_P2.54mm_Vertical.step

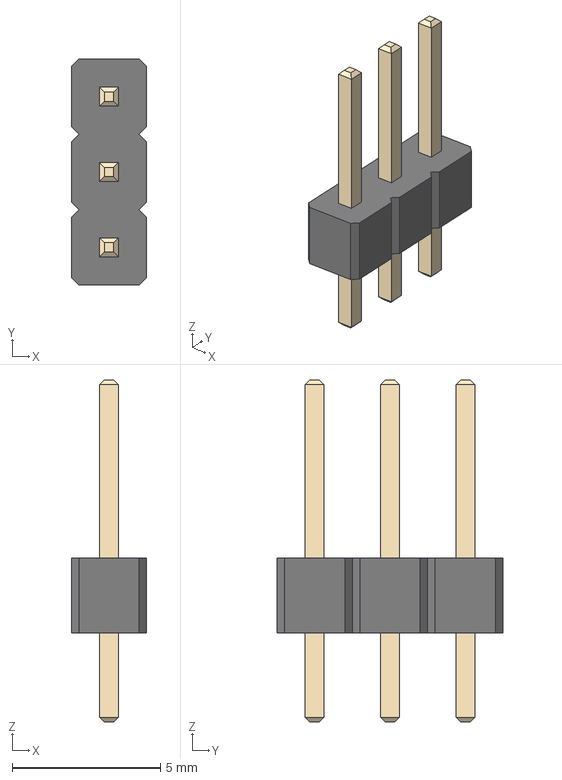
[picture p62: CAD file, 2018-02-05]
Modelos3d/PinHeader_1x03_P2.54mm_Vertical.step
2.54 x 7.62 x 11.5 mm
