EEST1/Entrenador4to2018/(list of files, cad)

Other CAD files:
Modelos3d/led_display_lts-547ag-1.snapshot.3/LTS-547AG.FCStd
Frente.FCStd
Gabinete2/perilla2lemos.stl
Gabinete2/perilla.stl
Modelos3d/4-different-switches-1.snapshot.2/Part1.SLDPRT
Modelos3d/4-different-switches-1.snapshot.2/Part2.SLDPRT
Modelos3d/4-different-switches-1.snapshot.2/Part3.SLDPRT
Modelos3d/4-different-switches-1.snapshot.2/Part4.SLDPRT
Modelos3d/fuse-holder-8.snapshot.4/Fuse holder.ipt
Modelos3d/potentiometer-rv16af-41-1.snapshot.2/potentiometer(RV16AF-41).SLDPRT
