EEST1/Entrenador4to2018/Documentación/Componentes.pdf

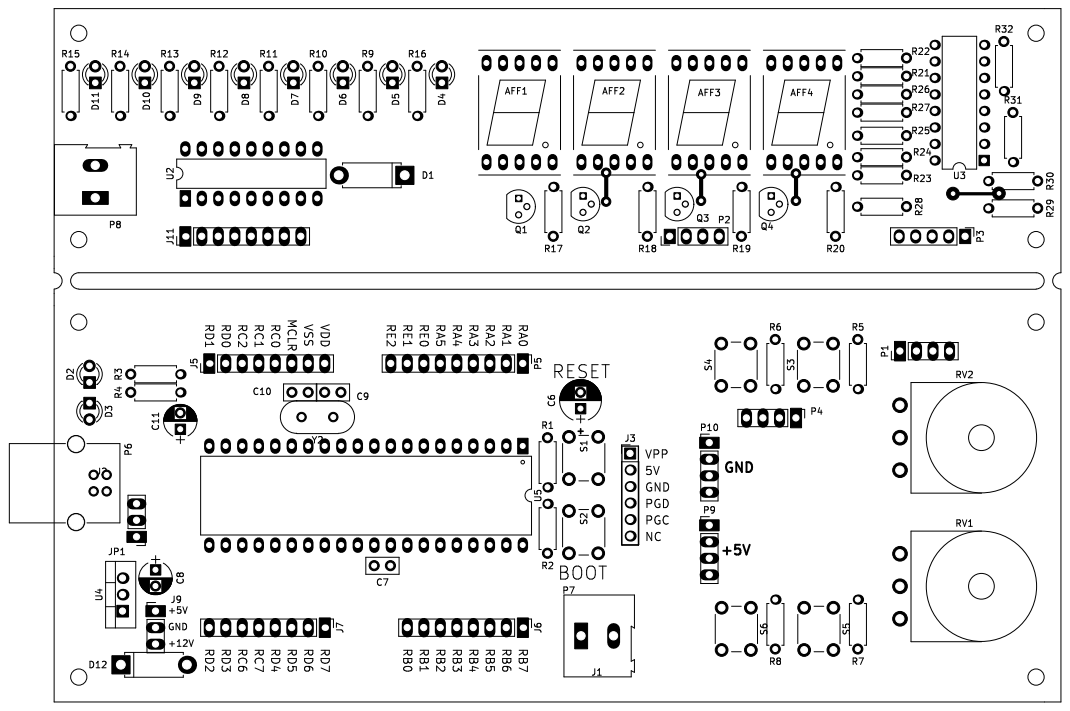
[picture p64: page 1]
