EEST1/Entrenador4to2018/Documentación/2020/imagenes/ComponentesEntrenador.pdf

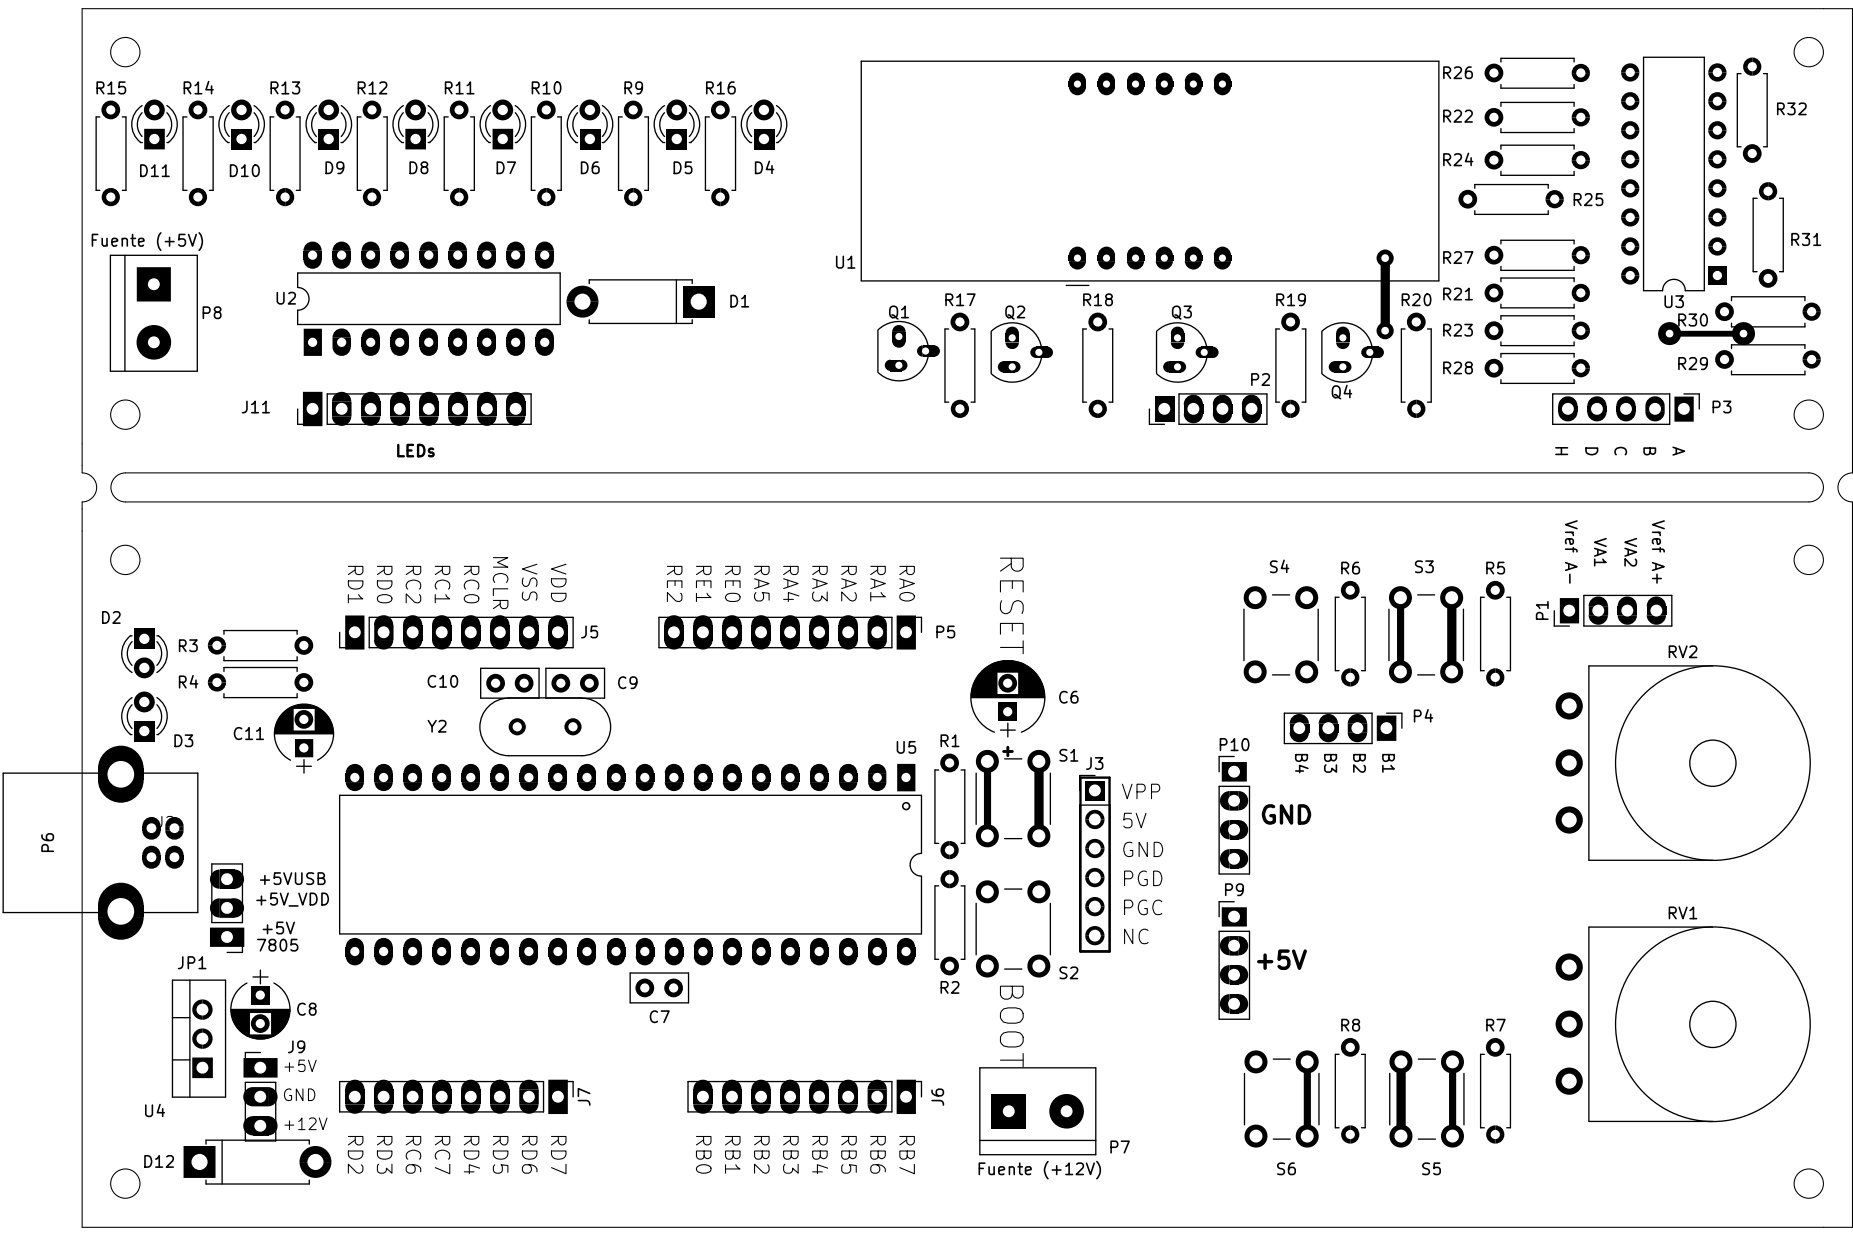
[picture p65: page 1]
