EEST1/Entrenador4to2018/Documentación/2020/imagenes/VistaComponentes-eps-converted-to.pdf

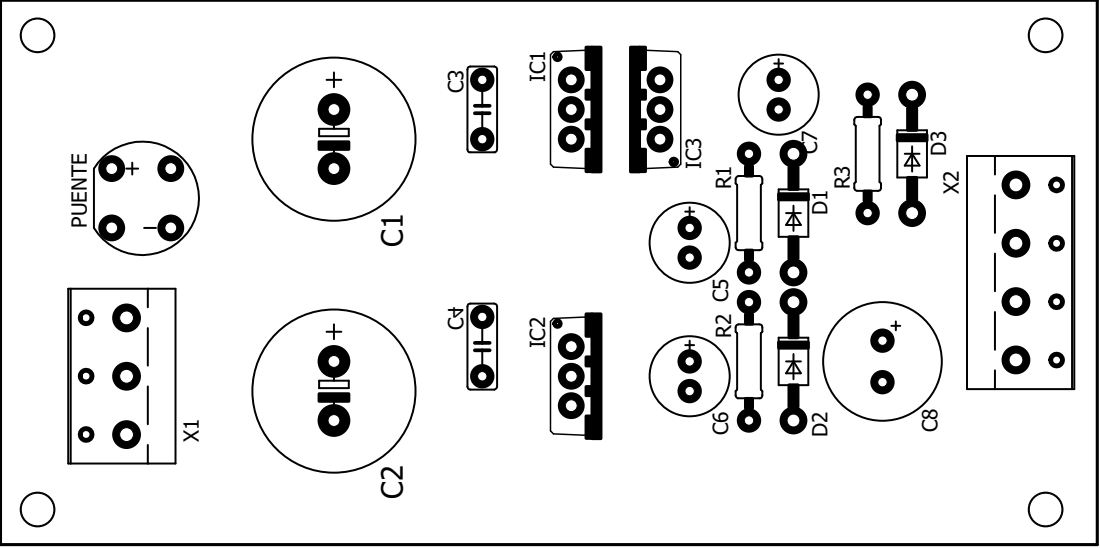
[picture p66: page 1]
