EEST1/Entrenador4to2018/Documentación/2020/imagenes/VistaComponentes.pdf

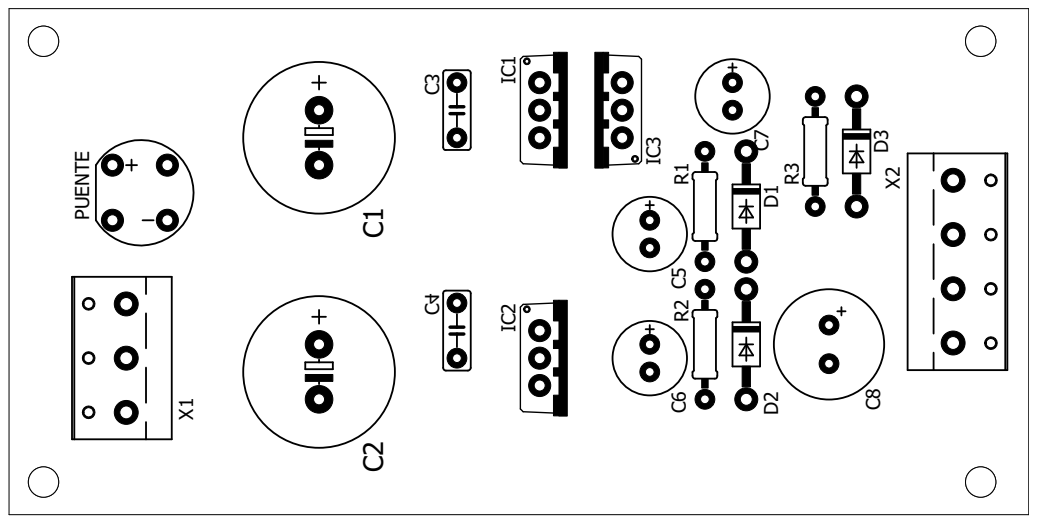
[picture p67: page 1]
