EEST1/Entrenador4to2018/GerberOutput/Entrenador1-SchDoc_4Display_en_uno-panel-B.Cu.pdf

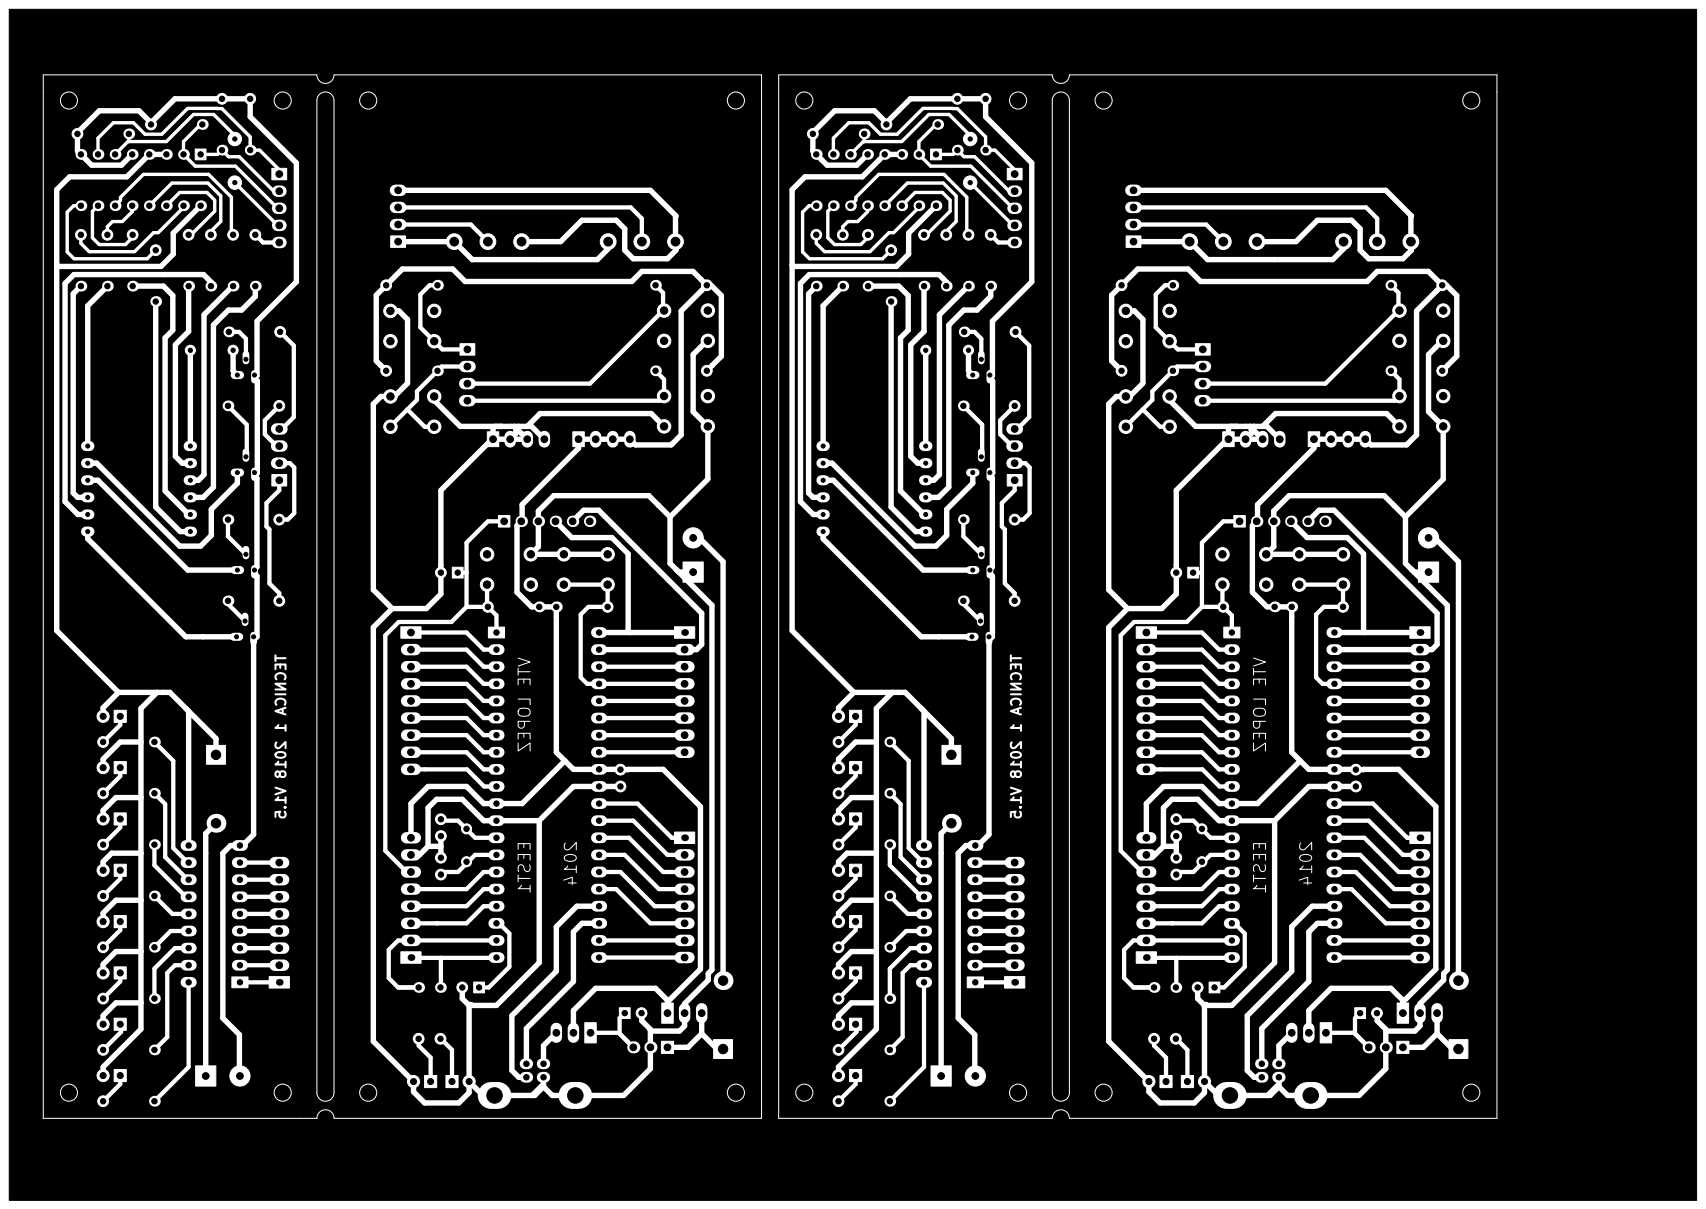
[picture p68: page 1]

EEST1 VTE LOPEZ 2014 TECNICA 1 2018 V1.5 TECNICA 1 2018 V1.5 2014 VTE LOPEZ EEST1
