EEST1/Entrenador4to2018/GerberOutput/Entrenador1-SchDoc_4Display_en_uno-Cmts.User.pdf

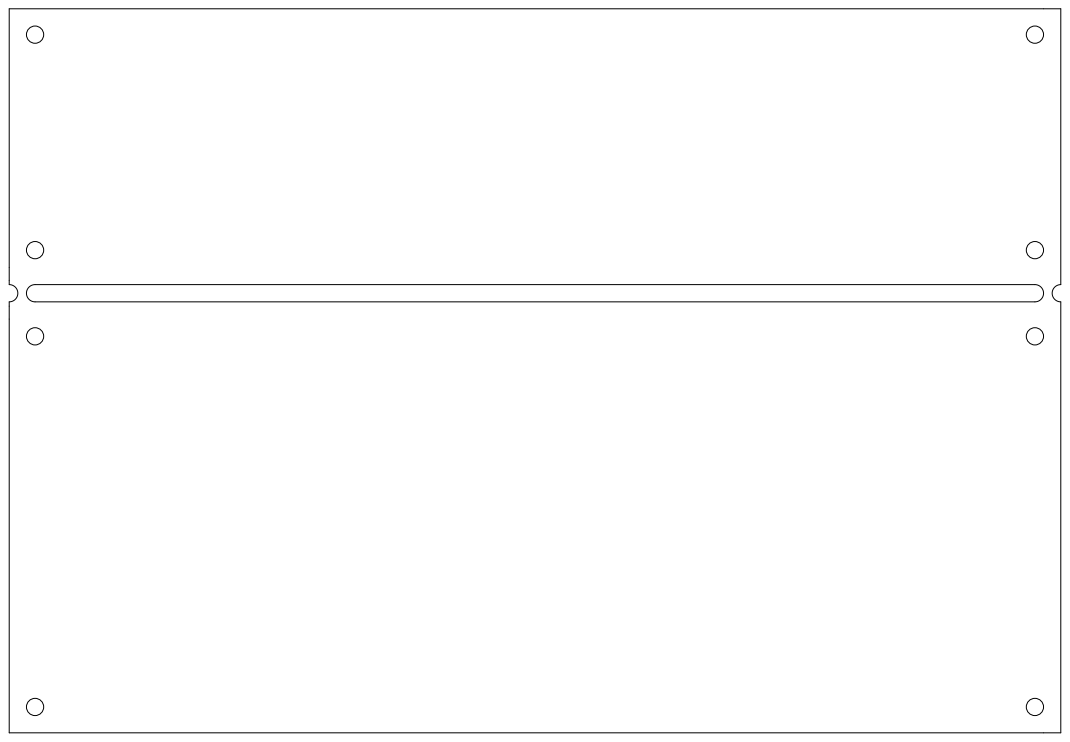
[picture p69: page 1]
