EEST1/Entrenador4to2018/GerberOutput/Entrenador1-SchDoc_4Display_en_uno-Dwgs.User.pdf

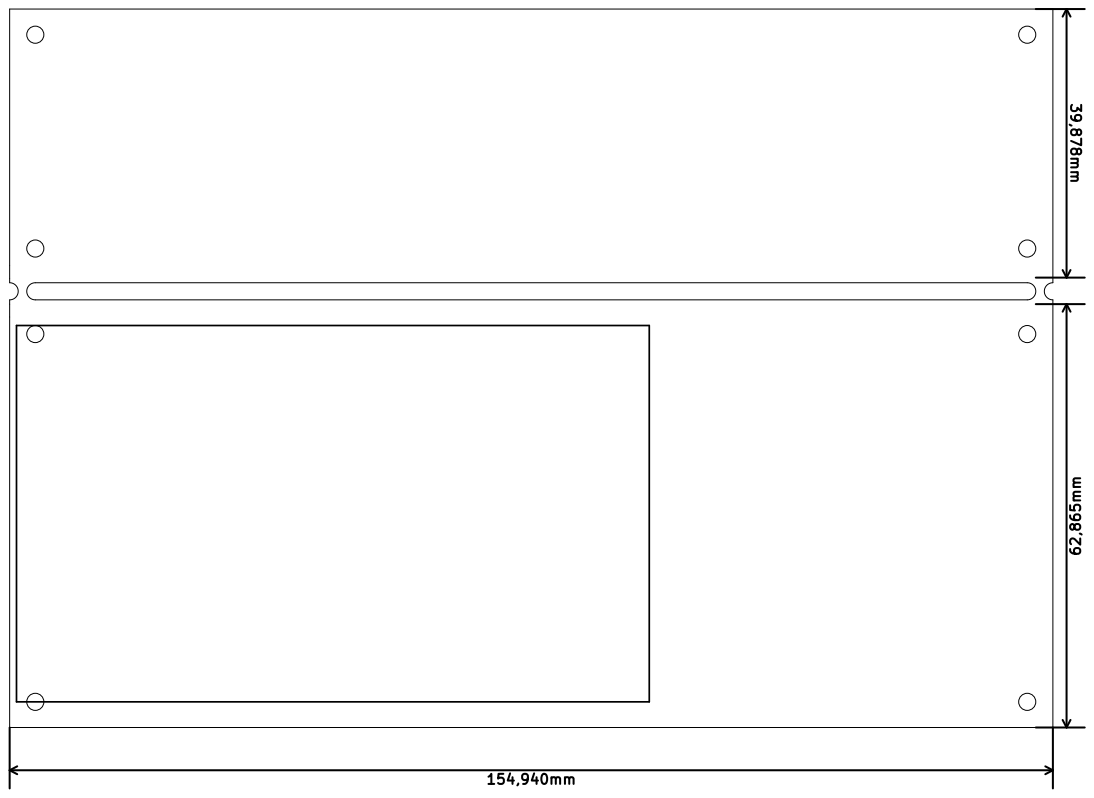
[picture p70: page 1]
