EEST1/Entrenador4to2018/GerberOutput/Entrenador1-SchDoc_4Display_en_uno-F.Cu.pdf

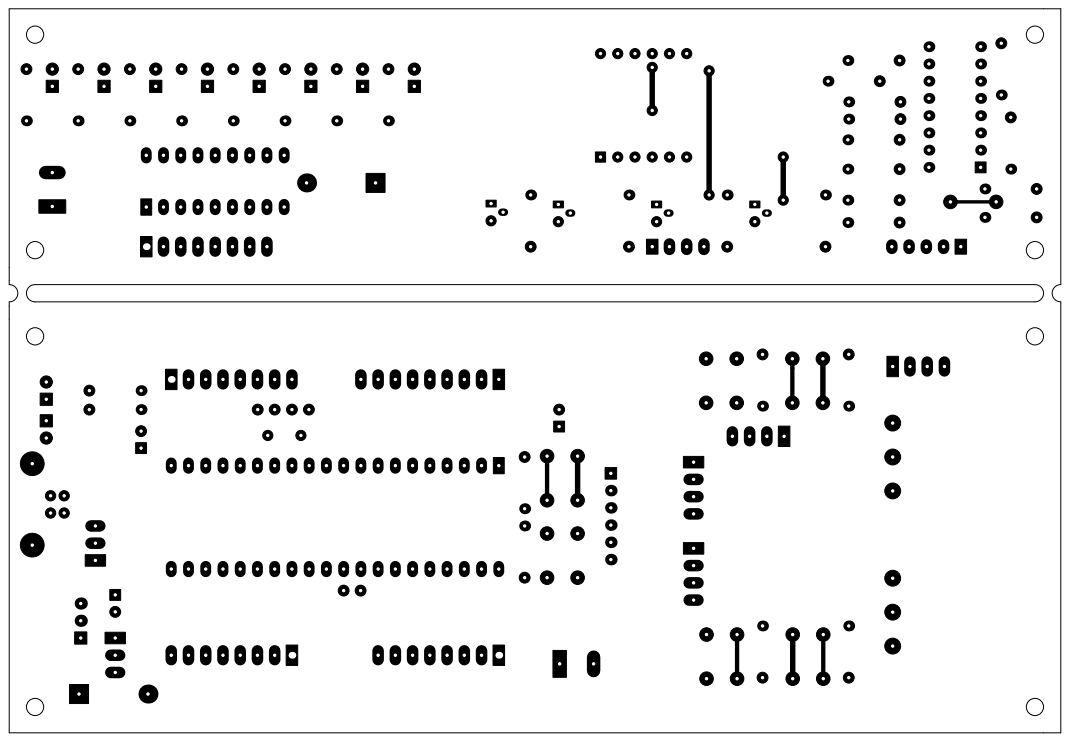
[picture p71: page 1]
