EEST1/Entrenador4to2018/GerberOutput/Entrenador1-SchDoc_4Display_en_uno-F.Mask.pdf

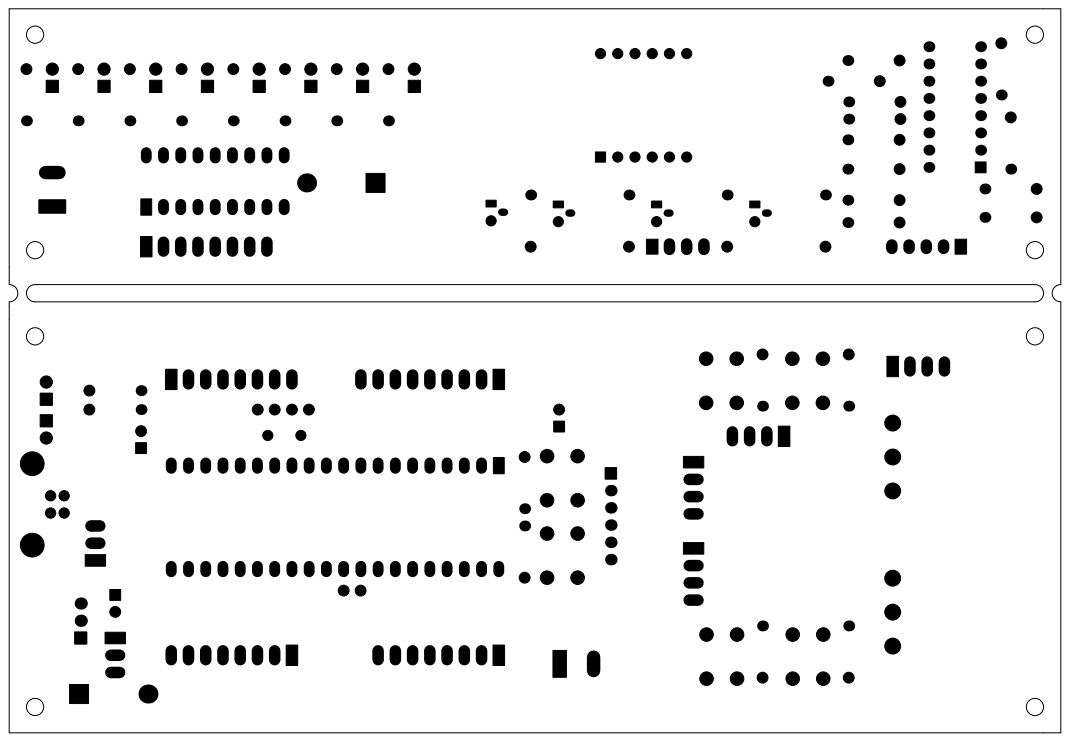
[picture p72: page 1]
