EEST1/Entrenador4to2018/GerberOutput/Entrenador1-SchDoc_4Display_en_uno-F.SilkS.pdf

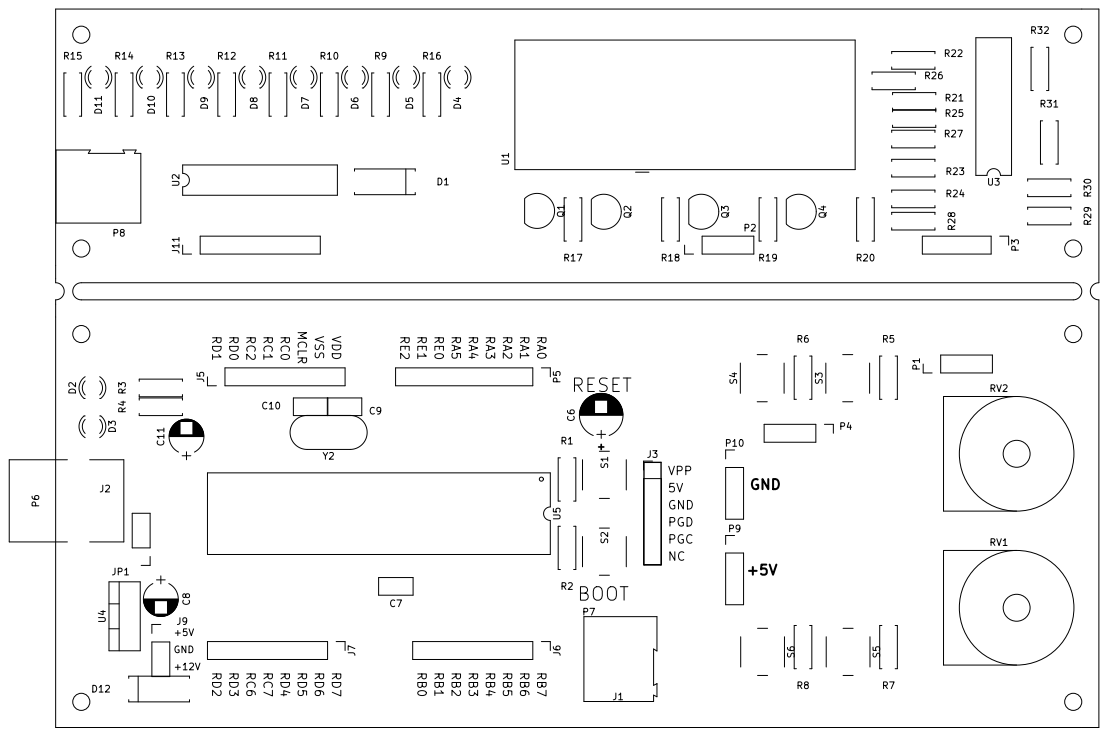
[picture p73: page 1]
