EEST1/Entrenador4to2018/Documentación/Cobre.pdf

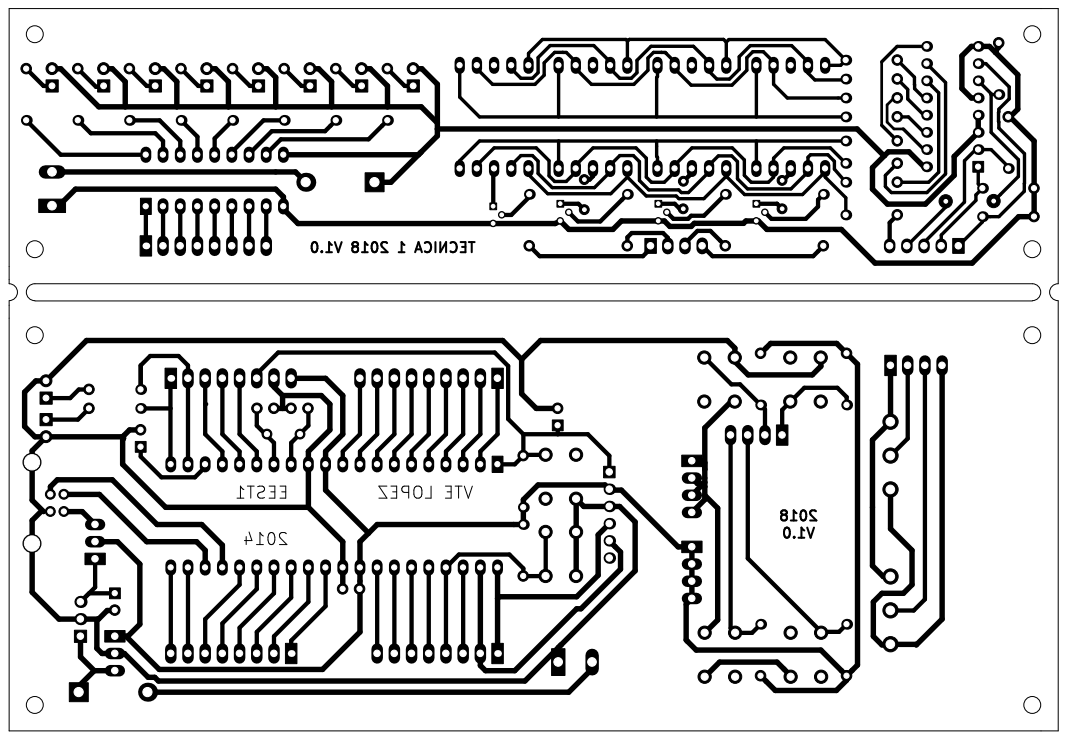
[picture p74: page 1]
