EEST1/Entrenador4to2018/Documentación/Esquema.pdf

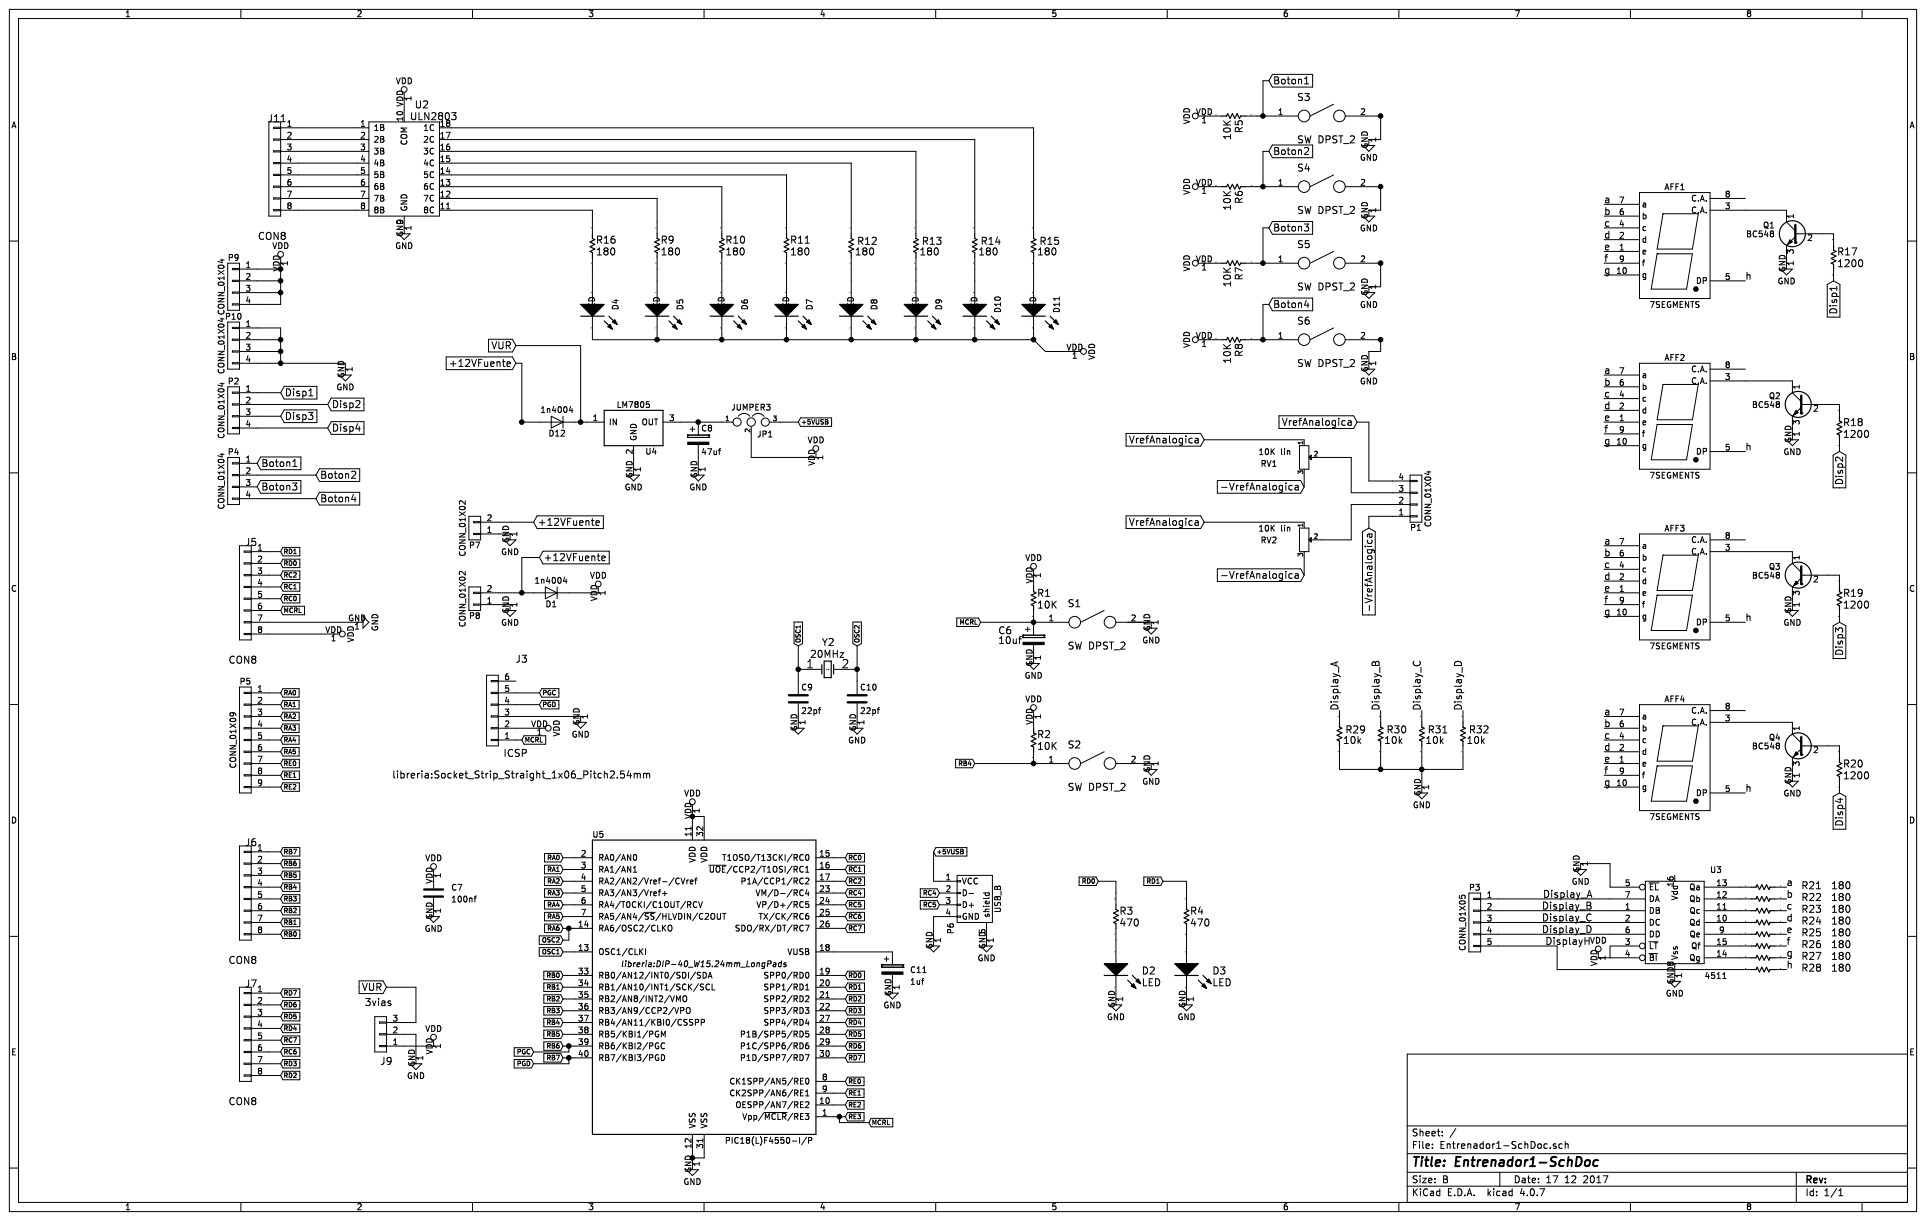
[picture p75: page 1]
