EEST1/Entrenador4to2018/Documentación/Valores.pdf

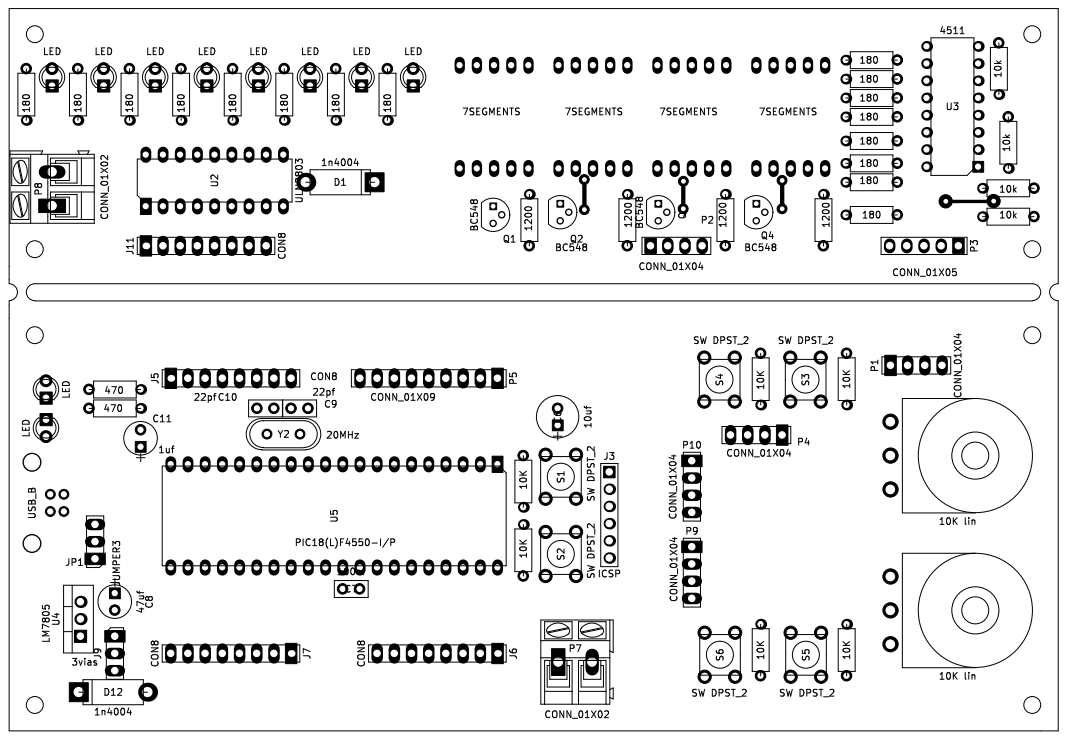
[picture p76: page 1]
