EEST1/Entrenador4to2018/Documentación/2020/imagenes/EsquematicoEntrenador.pdf

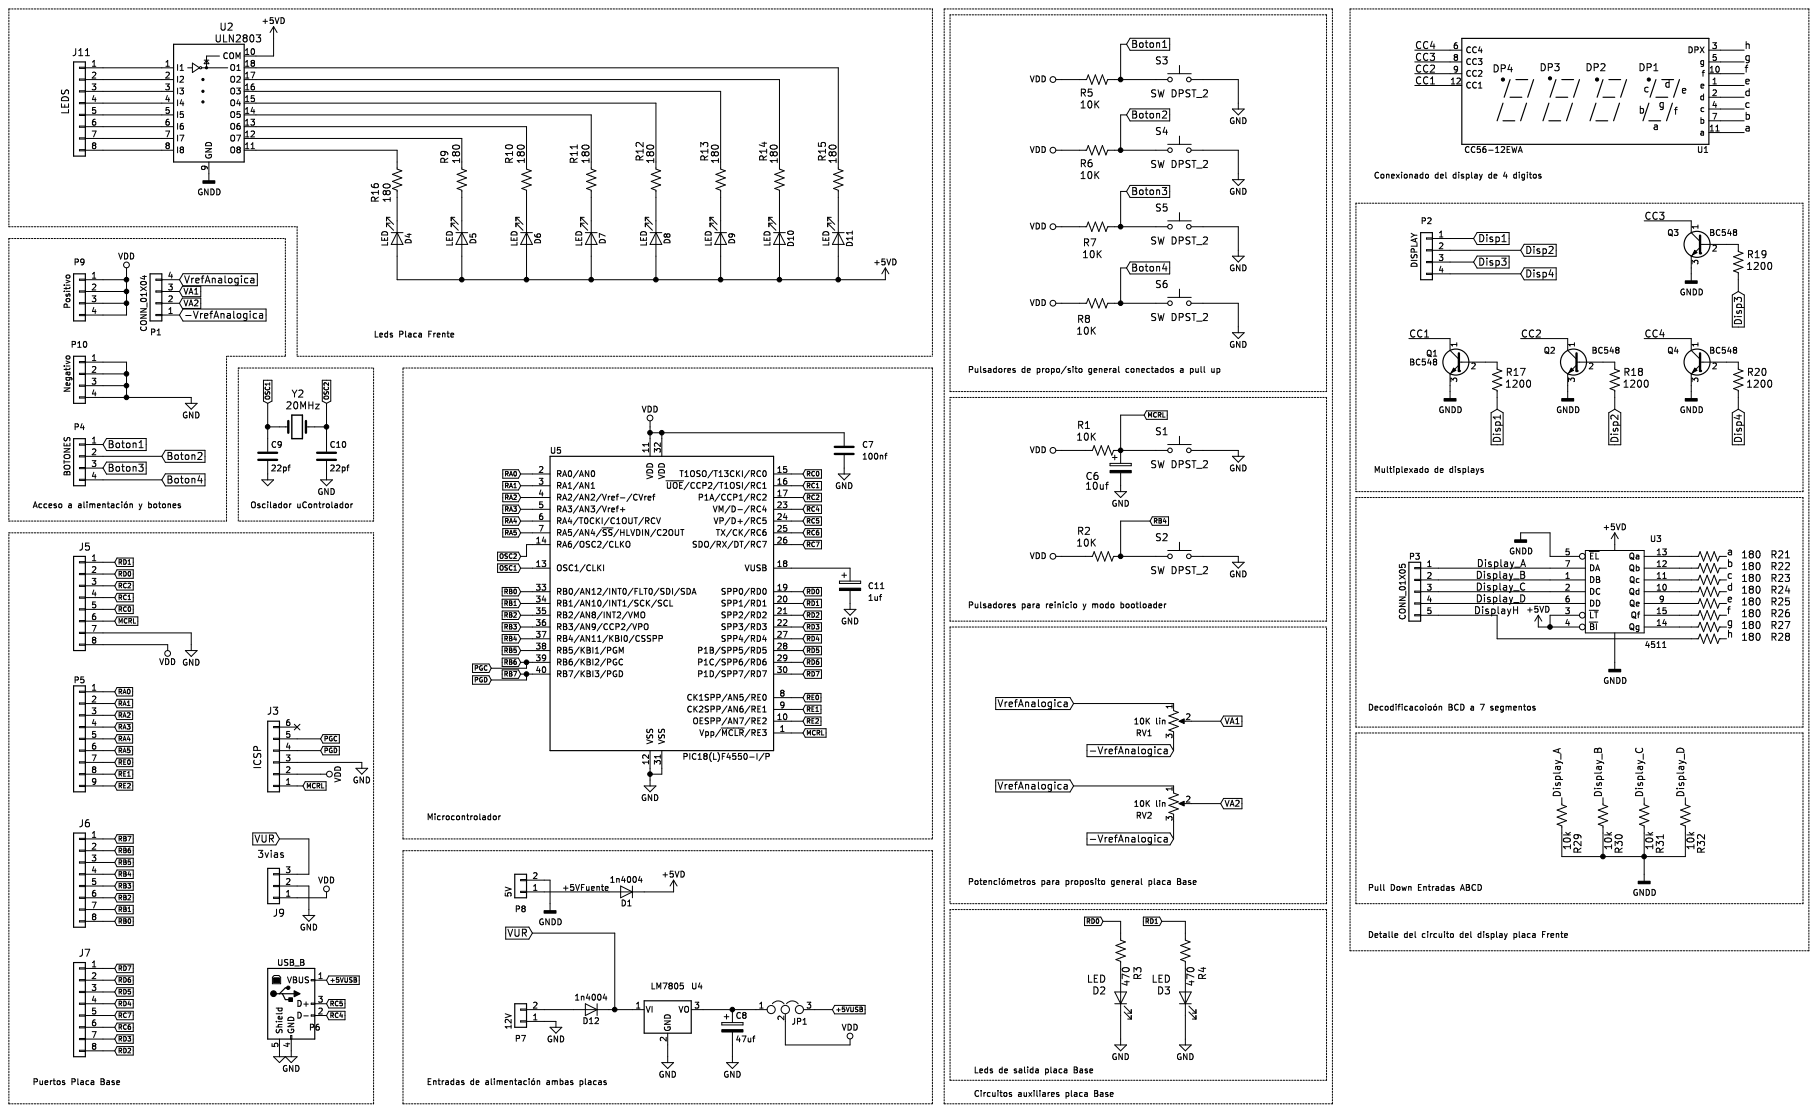
[picture p77: page 1]
