EEST1/Entrenador4to2018/Documentación/2020/imagenes/PistasEntrenador.pdf

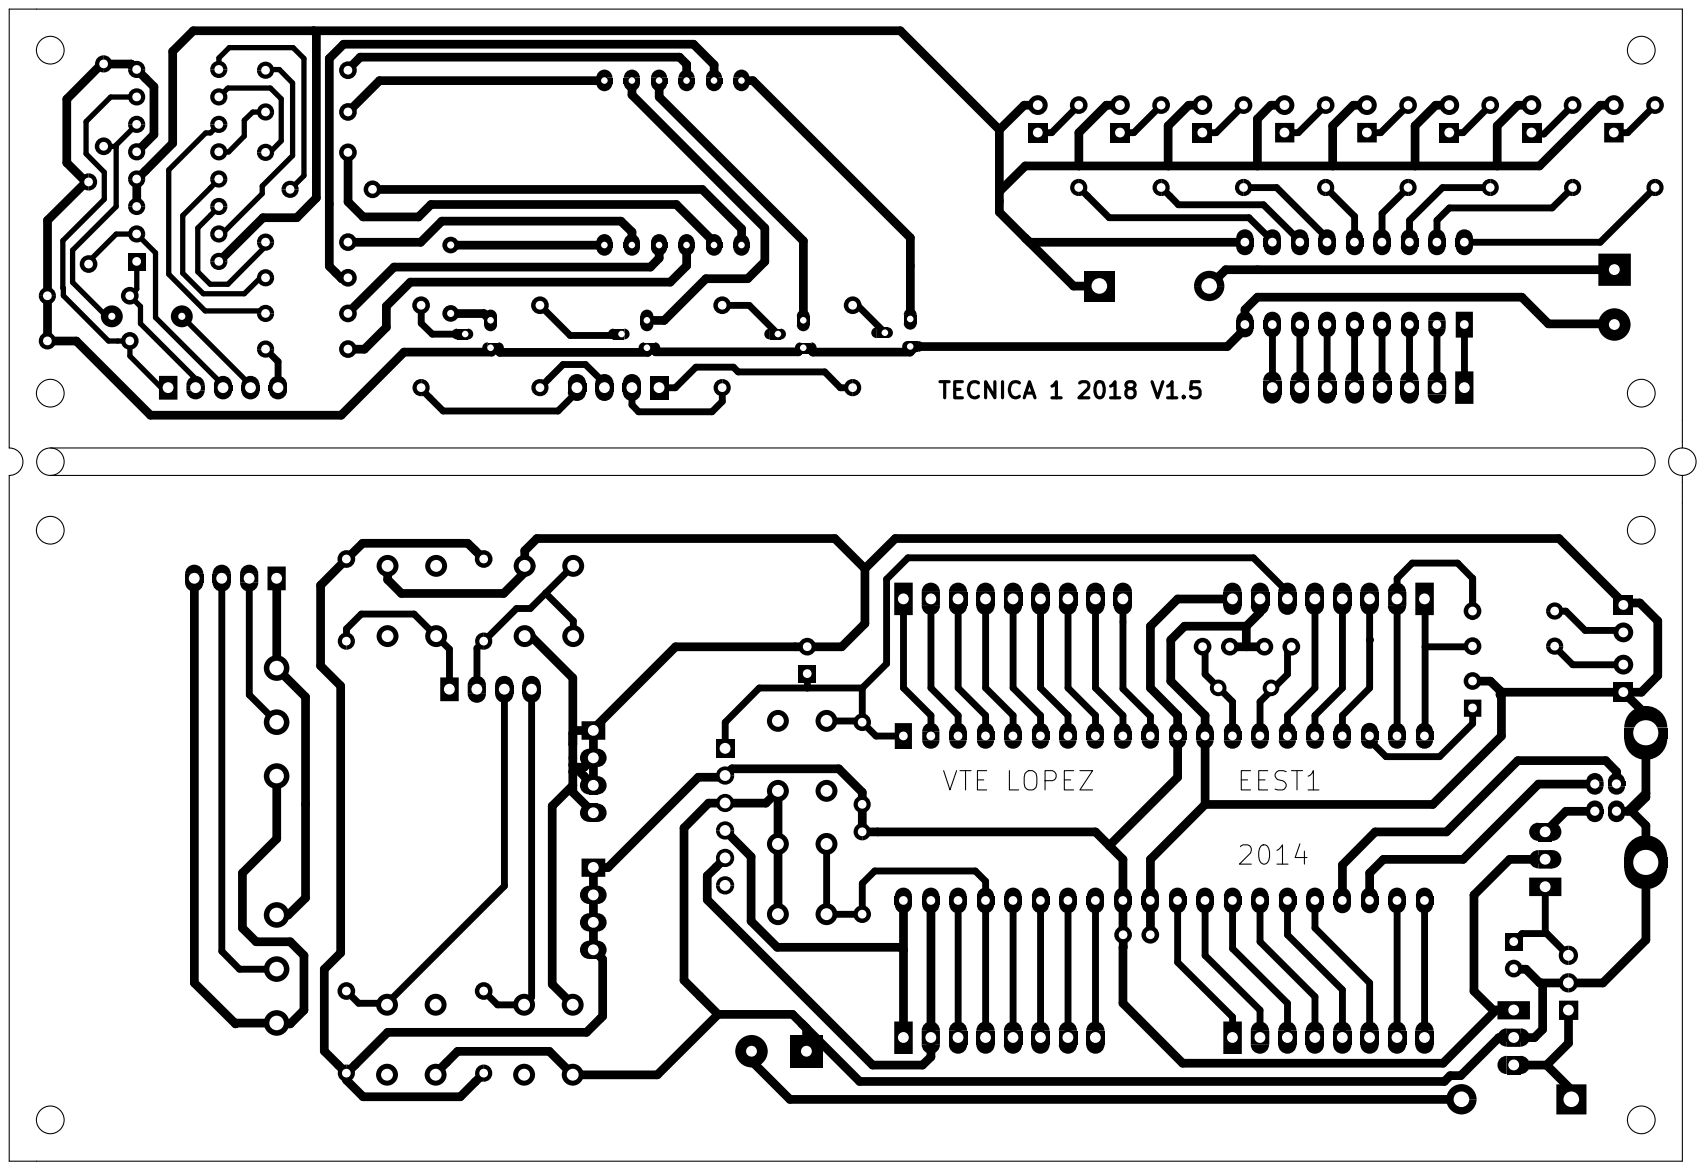
[picture p78: page 1]
