EEST1/Entrenador4to2018/Documentación/2020/imagenes/CircuitoFuente-eps-converted-to.pdf

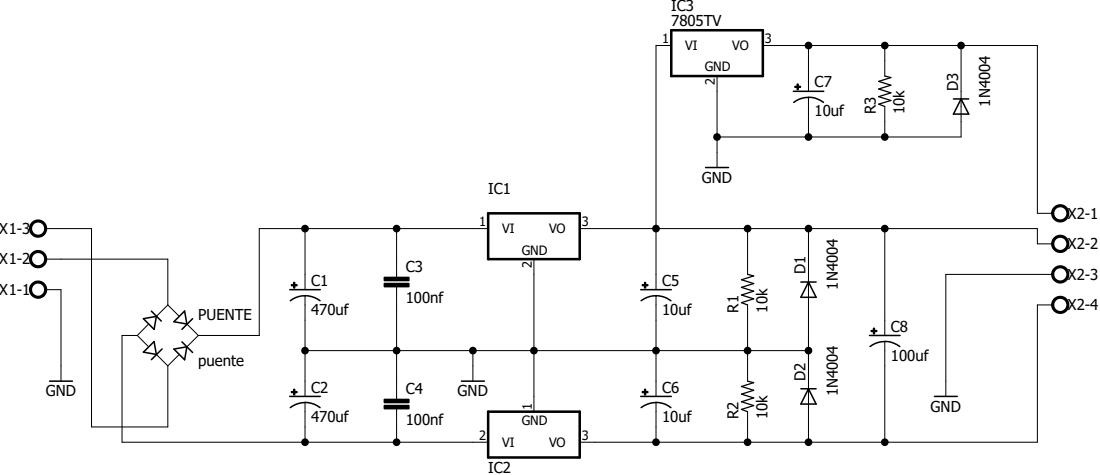
[picture p79: page 1]
