EEST1/Entrenador4to2018/Documentación/2020/imagenes/CircuitoFuente.pdf

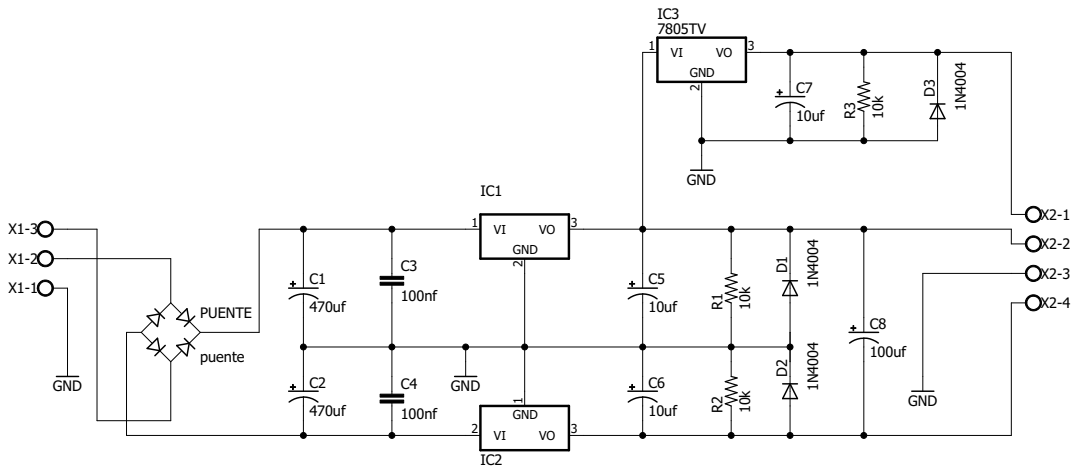
[picture p80: page 1]
