EEST1/Entrenador4to2018/Documentación/2020/imagenes/GabineteMaderav1.pdf

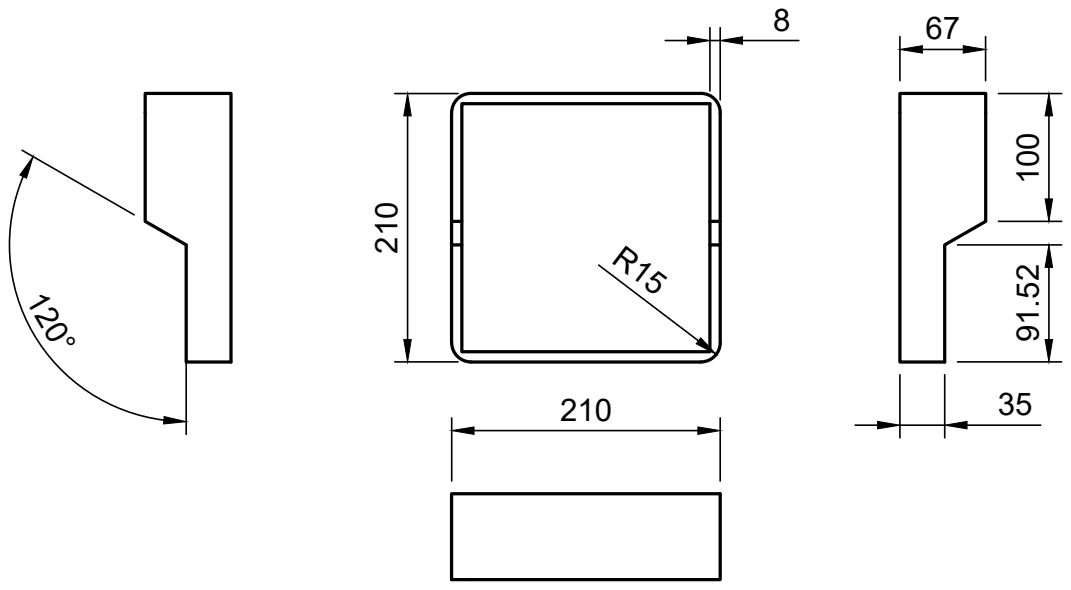
[picture p81: page 1]
