EEST1/Entrenador4to2018/Entrenador1-SchDoc_4Display_en_uno.kicad_pcb

## KiCad design Entrenador1-SchDoc_4Display_en_uno.kicad_pcb (2020-02-09)

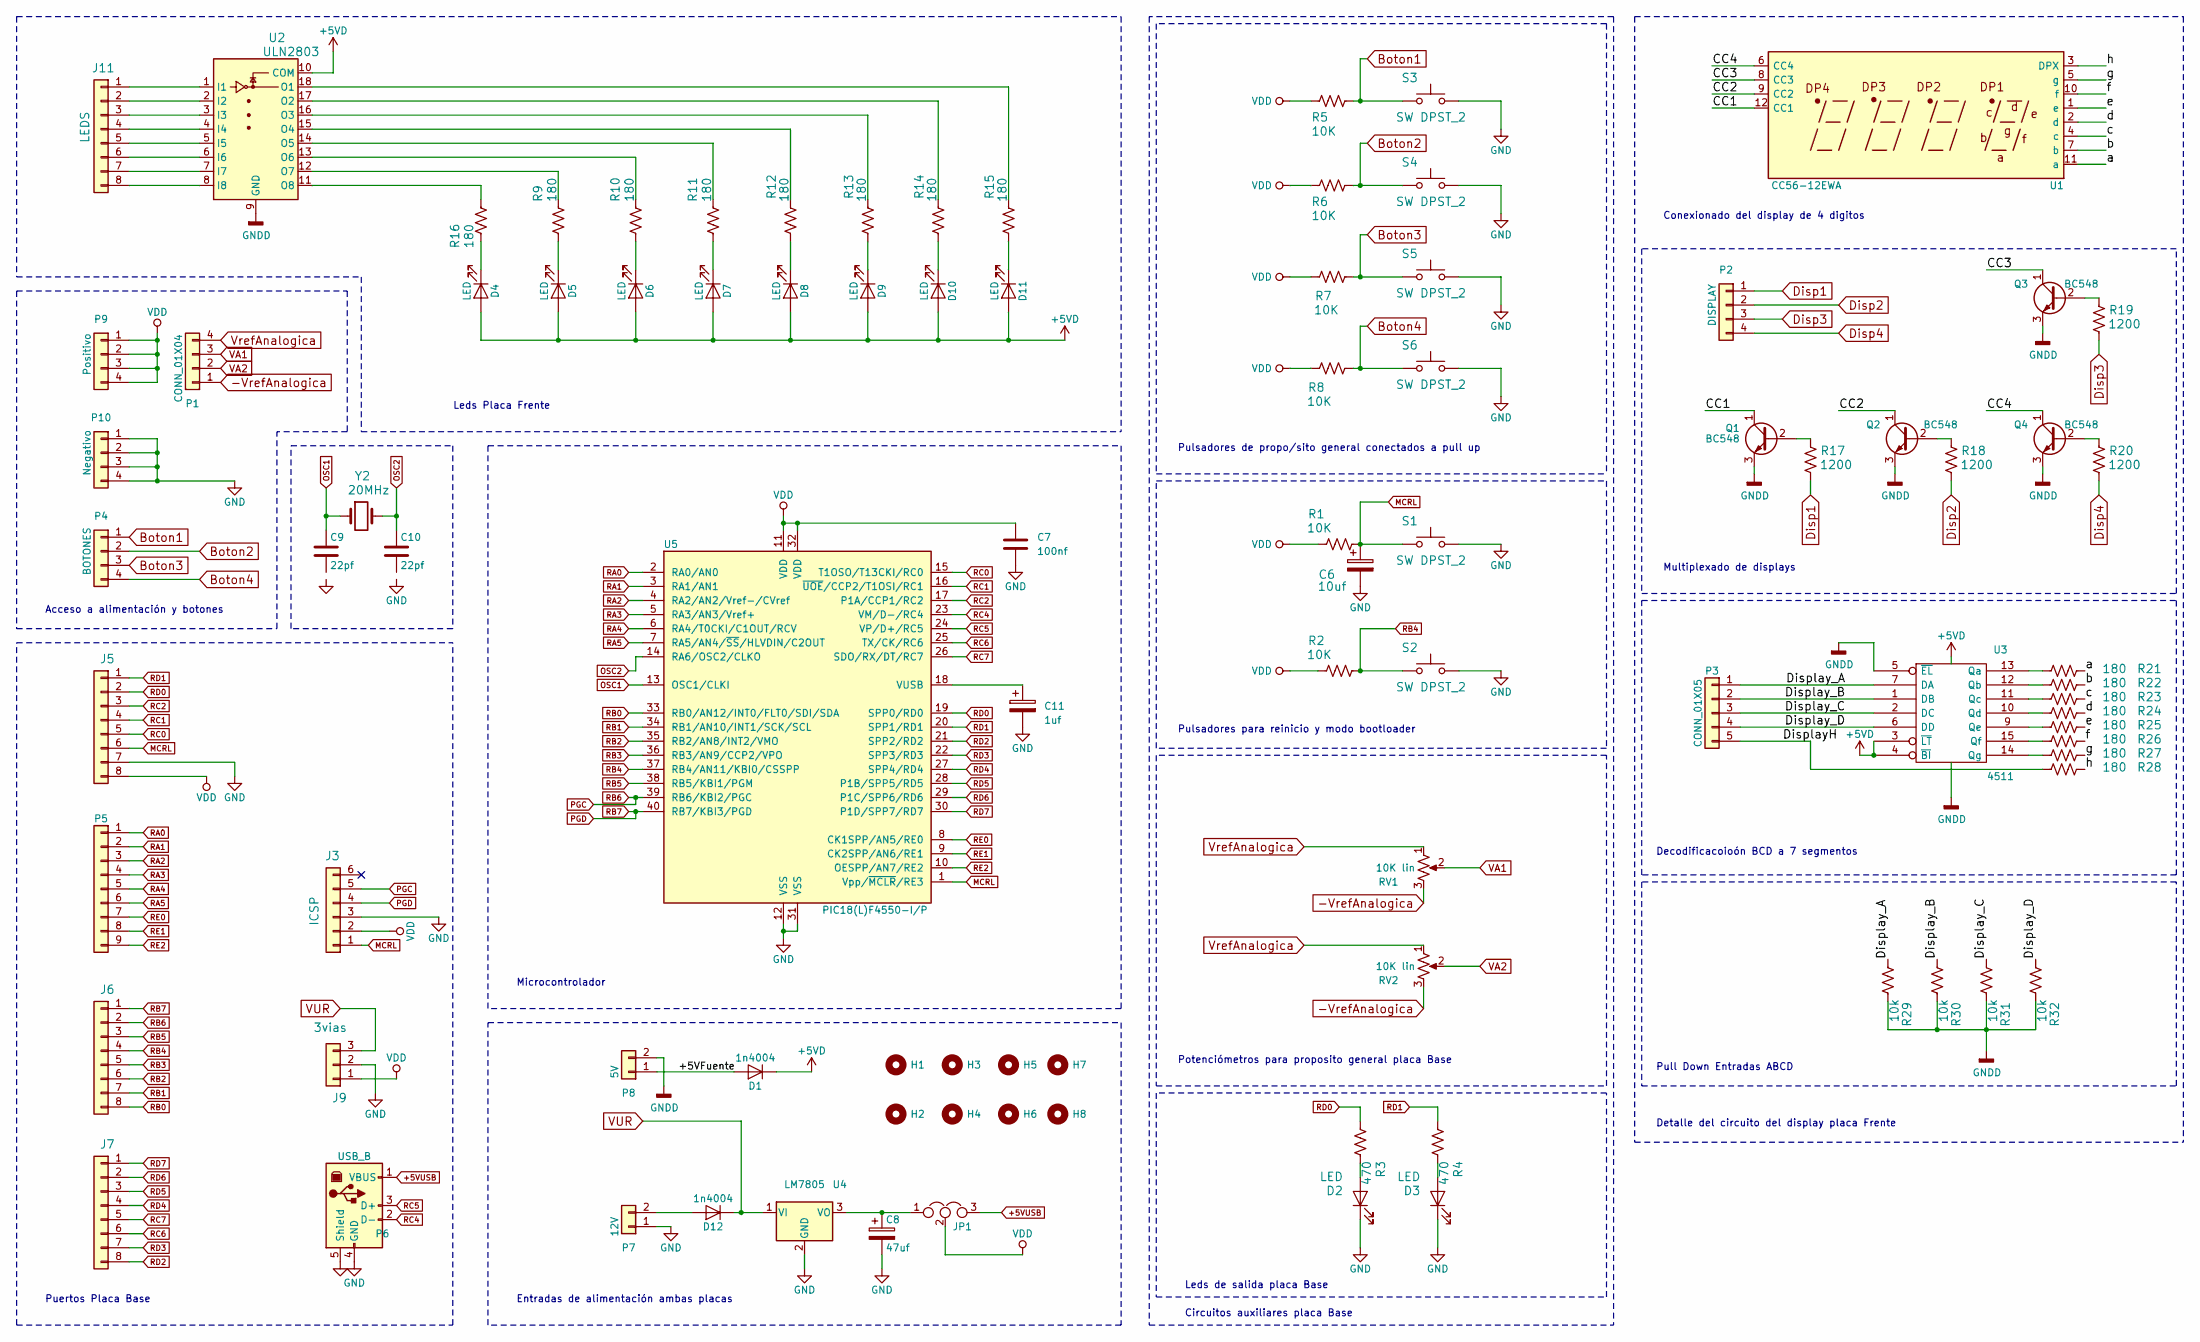
[picture p82: schematic Entrenador1-SchDoc_4Display_en_uno.sch, Entrenador1-SchDoc]

Parts:
C6: 10uf; CP_Radial_D6.3mm_P2.50mm
C7: 100nf; C_Disc_D5.0mm_W2.5mm_P2.50mm
C8: 47uf; CP_Radial_D5.0mm_P2.50mm
C9, C10: 22pf; C_Disc_D5.0mm_W2.5mm_P2.50mm
C11: 1uf; CP_Radial_D5.0mm_P2.50mm
D1, D12: 1n4004; D_5W_P10.16mm_Horizontal
D2, D3, D4, D5, D6, D7, D8, D9, D10, D11: LED; LED_D3.0mm
H1, H2, H3, H4, H5, H6, H7, H8: MountingHole; MountingHole_3.2mm_M3
J3: ICSP; Socket_Strip_Straight_1x06_Pitch2.54mm
J5, J6, J7: CON8; Socket_Strip_Straight_1x08_Pitch2.54mm
J9: 3vias; Pin_Header_Straight_1x03_Pitch2.54mm
J11: LEDS; Socket_Strip_Straight_1x08_Pitch2.54mm
JP1: JUMPER3; Pin_Header_Straight_1x03_Pitch2.54mm
P1: CONN_01X04; Socket_Strip_Straight_1x04_Pitch2.54mm
P2: DISPLAY; Socket_Strip_Straight_1x04_Pitch2.54mm
P3: CONN_01X05; Socket_Strip_Straight_1x05_Pitch2.54mm
P4: BOTONES; Socket_Strip_Straight_1x04_Pitch2.54mm
P5: CONN_01X09; Socket_Strip_Straight_1x09_Pitch2.54mm
P6: USB_B
P7: 12V; TerminalBlock_bornier-2_P5.08mm
P8: 5V; TerminalBlock_bornier-2_P5.08mm
P9: Positivo; Socket_Strip_Straight_1x04_Pitch2.54mm
P10: Negativo; Socket_Strip_Straight_1x04_Pitch2.54mm
Q1, Q2, Q3, Q4: BC548; TO-92_Molded_Narrow
R1, R2, R5, R6, R7, R8: 10K; R_Axial_DIN0207_L6.3mm_D2.5mm_P7.62mm_Horizontal
R3, R4: 470; R_Axial_DIN0207_L6.3mm_D2.5mm_P7.62mm_Horizontal
R9, R10, R11, R12, R13, R14, R15, R16, R21, R22, R23, R24, R25, R26, R27, R28: 180; R_Axial_DIN0207_L6.3mm_D2.5mm_P7.62mm_Horizontal
R17, R18, R19, R20: 1200; R_Axial_DIN0207_L6.3mm_D2.5mm_P7.62mm_Horizontal
R29, R30, R31, R32: 10k; R_Axial_DIN0207_L6.3mm_D2.5mm_P7.62mm_Horizontal
RV1, RV2: 10K lin; Potentiometer_Omeg_PC16PU_Horizontal
S1, S2, S3, S4, S5, S6: SW DPST_2; SW_PUSH_6mm_h13mm
U1: CC56-12EWA; CA56-12EWA
U2: ULN2803; DIP-18_W7.62mm_LongPads
U3: 4511; DIP-16_W7.62mm
U4: LM7805; TO-220-3_Vertical
U5: PIC18(L)F4550-I/P; DIP-40_W15.24mm_LongPads
Y2: 20MHz; Crystal_HC49-4H_Vertical

Connections:
+5VD: D1.1 (K), D4.2 (A), D5.2 (A), D6.2 (A), D7.2 (A), D8.2 (A), D9.2 (A), D10.2 (A), D11.2 (A), U2.10 (COM), U3.3 (~LT), U3.4 (~BI), U3.16 (Vdd)
+5VUSB: JP1.3, P6.1 (VBUS)
-VrefAnalogica: P1.1, RV1.3, RV2.3
/+5VFuente: D1.2 (A), P8.1
/CC1: Q1.1 (C), U1.12 (CC1)
/CC2: Q2.1 (C), U1.9 (CC2)
/CC3: Q3.1 (C), U1.8 (CC3)
/CC4: Q4.1 (C), U1.6 (CC4)
/DisplayH: P3.5, R28.2
/Display_A: P3.1, R29.1, U3.7 (DA)
/Display_B: P3.2, R30.1, U3.1 (DB)
/Display_C: P3.3, R31.1, U3.2 (DC)
/Display_D: P3.4, R32.1, U3.6 (DD)
/a: R21.1, U1.11 (a)
/b: R22.1, U1.7 (b)
/c: R23.1, U1.4 (c)
/d: R24.1, U1.2 (d)
/e: R25.1, U1.1 (e)
/f: R26.1, U1.10 (f)
/g: R27.1, U1.5 (g)
/h: R28.1, U1.3 (DPX)
Boton1: P4.1, R5.2, S3.1
Boton2: P4.2, R6.2, S4.1
Boton3: P4.3, R7.1, S5.1
Boton4: P4.4, R8.1, S6.1
Disp1: P2.1, R17.2
Disp2: P2.2, R18.2
Disp3: P2.3, R19.2
Disp4: P2.4, R20.2
GND: C6.2, C7.2, C8.2, C11.2, D2.1 (K), D3.1 (K), J3.3, J5.7, J9.2, P6.4 (GND), P6.5 (Shield), P7.1, P10.1, P10.2, P10.3, P10.4, S1.2, S2.2, S3.2, S4.2, S5.2, S6.2, U4.2 (GND), U5.12 (VSS), U5.31 (VSS)
GNDD: P8.2, Q1.3 (E), Q2.3 (E), Q3.3 (E), Q4.3 (E), R29.2, R30.2, R31.2, R32.2, U2.9 (GND), U3.5 (~EL), U3.8 (Vss)
MCRL: C6.1, J3.1, J5.6, R1.1, S1.1, U5.1 (Vpp/~MCLR~/RE3)
unnamed: C8.1, JP1.1, U4.3 (VO)
unnamed: C11.1, U5.18 (VUSB)
unnamed: D2.2 (A), R3.2
unnamed: D3.2 (A), R4.2
unnamed: D4.1 (K), R16.1
unnamed: D5.1 (K), R9.1
unnamed: D6.1 (K), R10.1
unnamed: D7.1 (K), R11.1
unnamed: D8.1 (K), R12.1
unnamed: D9.1 (K), R13.1
unnamed: D10.1 (K), R14.1
unnamed: D11.1 (K), R15.1
unnamed: D12.2 (A), P7.2
unnamed: J11.1, U2.1 (I1)
unnamed: J11.2, U2.2 (I2)
unnamed: J11.3, U2.3 (I3)
unnamed: J11.4, U2.4 (I4)
unnamed: J11.5, U2.5 (I5)
unnamed: J11.6, U2.6 (I6)
unnamed: J11.7, U2.7 (I7)
unnamed: J11.8, U2.8 (I8)
unnamed: Q1.2 (B), R17.1
unnamed: Q2.2 (B), R18.1
unnamed: Q3.2 (B), R19.1
unnamed: Q4.2 (B), R20.1
unnamed: R9.2, U2.12 (O7)
unnamed: R10.2, U2.13 (O6)
unnamed: R11.2, U2.14 (O5)
unnamed: R12.2, U2.15 (O4)
unnamed: R13.2, U2.16 (O3)
unnamed: R14.2, U2.17 (O2)
unnamed: R15.2, U2.18 (O1)
unnamed: R16.2, U2.11 (O8)
unnamed: R21.2, U3.13 (Qa)
unnamed: R22.2, U3.12 (Qb)
unnamed: R23.2, U3.11 (Qc)
unnamed: R24.2, U3.10 (Qd)
unnamed: R25.2, U3.9 (Qe)
unnamed: R26.2, U3.15 (Qf)
unnamed: R27.2, U3.14 (Qg)
OSC1: C9.1, U5.13 (OSC1/CLKI), Y2.1
OSC2: C10.1, U5.14 (RA6/OSC2/CLKO), Y2.2
PGC: J3.5, J6.2, U5.39 (RB6/KBI2/PGC)
PGD: J3.4, J6.1, U5.40 (RB7/KBI3/PGD)
RA0: P5.1, U5.2 (RA0/AN0)
RA1: P5.2, U5.3 (RA1/AN1)
RA2: P5.3, U5.4 (RA2/AN2/Vref-/CVref)
RA3: P5.4, U5.5 (RA3/AN3/Vref+)
RA4: P5.5, U5.6 (RA4/T0CKI/C1OUT/RCV)
RA5: P5.6, U5.7 (RA5/AN4/~SS~/HLVDIN/C2OUT)
RB0: J6.8, U5.33 (RB0/AN12/INT0/FLT0/SDI/SDA)
RB1: J6.7, U5.34 (RB1/AN10/INT1/SCK/SCL)
RB2: J6.6, U5.35 (RB2/AN8/INT2/VMO)
RB3: J6.5, U5.36 (RB3/AN9/CCP2/VPO)
RB4: J6.4, R2.1, S2.1, U5.37 (RB4/AN11/KBI0/CSSPP)
RB5: J6.3, U5.38 (RB5/KBI1/PGM)
RC0: J5.5, U5.15 (T1OSO/T13CKI/RC0)
RC1: J5.4, U5.16 (~UOE~/CCP2/T1OSI/RC1)
RC2: J5.3, U5.17 (P1A/CCP1/RC2)
RC4: P6.2 (D-), U5.23 (VM/D-/RC4)
RC5: P6.3 (D+), U5.24 (VP/D+/RC5)
RC6: J7.6, U5.25 (TX/CK/RC6)
RC7: J7.5, U5.26 (SDO/RX/DT/RC7)
RD0: J5.2, R3.1, U5.19 (SPP0/RD0)
RD1: J5.1, R4.1, U5.20 (SPP1/RD1)
RD2: J7.8, U5.21 (SPP2/RD2)
RD3: J7.7, U5.22 (SPP3/RD3)
RD4: J7.4, U5.27 (SPP4/RD4)
RD5: J7.3, U5.28 (P1B/SPP5/RD5)
RD6: J7.2, U5.29 (P1C/SPP6/RD6)
RD7: J7.1, U5.30 (P1D/SPP7/RD7)
RE0: P5.7, U5.8 (CK1SPP/AN5/RE0)
RE1: P5.8, U5.9 (CK2SPP/AN6/RE1)
RE2: P5.9, U5.10 (OESPP/AN7/RE2)
VA1: P1.3, RV1.2
VA2: P1.2, RV2.2
VDD: C7.1, J3.2, J5.8, J9.1, JP1.2, P9.1, P9.2, P9.3, P9.4, R1.2, R2.2, R5.1, R6.1, R7.2, R8.2, U5.11 (VDD), U5.32 (VDD)
VUR: D12.1 (K), J9.3, U4.1 (VI)
VrefAnalogica: P1.4, RV1.1, RV2.1

Notes on the sheet:
Decodificacoioón BCD a 7 segmentos
Pull Down Entradas ABCD
Pulsadores de propo/sito general conectados a pull up
Pulsadores para reinicio y modo bootloader
Potenciómetros para proposito general placa Base
Puertos Placa Base
Multiplexado de displays
Conexionado del display de 4 digitos
Entradas de alimentación ambas placas
Leds de salida placa Base
Acceso a alimentación y botones
Microcontrolador
Leds Placa Frente
Detalle del circuito del display placa Frente
Circuitos auxiliares placa Base

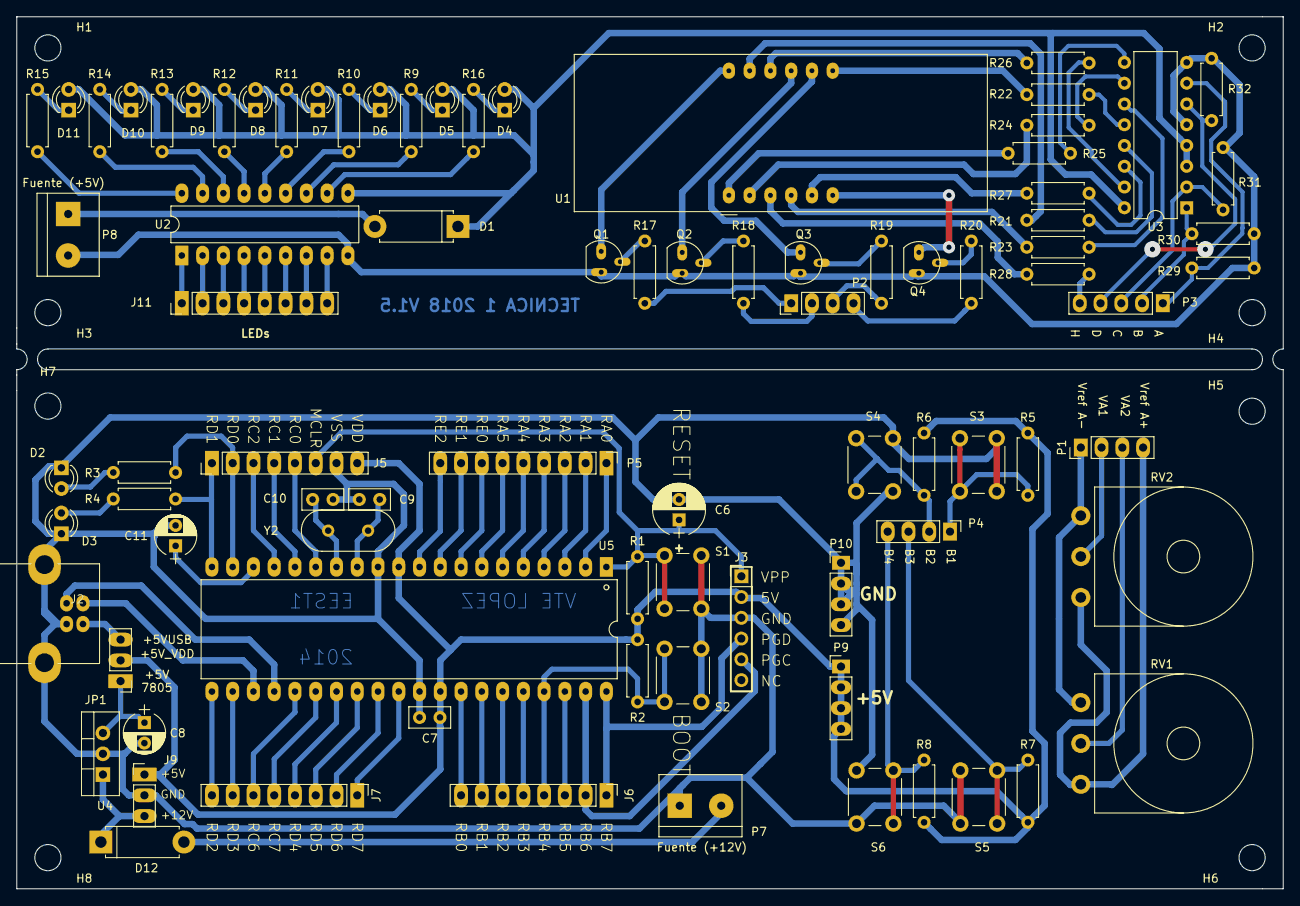
[picture p83: board Entrenador1-SchDoc_4Display_en_uno.kicad_pcb from above]

Board: 2 copper layers, 154.9 x 106.7 mm, 93 parts (0 on the bottom side), 111 nets.
