EEST1/Entrenador4to2018/(commit log)

2018-02-05 Initial commit
    Changes to be committed:
    new file: Base.kicad_pcb-bak
    new file: Entrenador1-SchDoc-cache.lib
    new file: Entrenador1-SchDoc-rescue.lib
    new file: Entrenador1-SchDoc.bak
    new file: Entrenador1-SchDoc.cmp
    new file: Entrenador1-SchDoc.kicad_pcb
    new file: Entrenador1-SchDoc.kicad_pcb-bak
    new file: Entrenador1-SchDoc.net
    new file: Entrenador1-SchDoc.pro
    new file: Entrenador1-SchDoc.sch
    new file: Gabinete/Base.FCStd
    new file: Gabinete/Base.FCStd1
    new file: Gabinete/Base.step
    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
    [7SegmentLED_LTS6760_LTS6780.step, 9v_Transformer.step, BARREL_JACK.stl, CP_Radial_D5.0mm_P2.50mm.step, CP_Radial_D6.3mm_P2.50mm.step, C_Disc_D5.0mm_W2.5mm_P2.50mm.step, Crystal_HC49-4H_Vertical.step, DISPLAY 7SEG.STEP]
2018-02-05 en proceso de creación
2018-02-05 adición del BOM
    [Entrenador1-SchDoc.kicad_pcb, Entrenador1-SchDoc.sch]
2018-02-05 ajustes BOM
    [Entrenador1-SchDoc.ods]
2018-02-06 se agrandan PADS
    [Entrenador1-SchDoc.kicad_pcb]
2018-02-07 cambio de huellas transistores, ajuste de pistas según prototipo
    [Entrenador1-SchDoc.kicad_pcb, Entrenador1-SchDoc.sch]
2018-02-09 En base al prototipo, se replantean las posiciones de los elementos
    [Entrenador1-SchDoc.kicad_pcb, Entrenador1-SchDoc.sch]
2018-02-10 Se agrega un diodo de protección a la placa de visualización Se eliminan los pines extra de alimentación de la placa de visualización
    [Entrenador1-SchDoc.kicad_pcb, Entrenador1-SchDoc.sch]
2018-02-14 se separan las placas de frente y base
2018-02-14 se agregan los archivos de BAse y Frente
    [Base.kicad_pcb, Entrenador1_SchDoc.FCStd, Frente.kicad_pcb]
2018-02-14 Se modifica el gabinete
    [Base.FCStd, DIP-16_W7.62mm.step, DIP-18_W7.62mm.step, Frente.FCStd, Frente.kicad_pcb, Frente1.step, PinSocket_1x05_P2.54mm_Vertical.step]
2018-02-24 Bugs en PCNEW
    [Base.FCStd, Base.kicad_pcb, Entrenador1-SchDoc.kicad_pcb]
2018-02-24 Avances sobre el gabinete
2018-02-26 Se agregan los orificios de fijación basados en el prototipo real
2018-03-02 Se realizan las perforaciones de fijaci[on frontal
2018-03-16 se cambia de posición el teclado
    [Entrenador1-SchDoc.kicad_pcb]
2018-03-24 Diseño definitivo con desplazamiento USB
    [Base.kicad_pcb, Entrenador1-SchDoc.kicad_pcb, usb_B.STEP]
2018-03-24 Pequeños ajustes repecto de las capas de información en el PCB
    [Entrenador1-SchDoc.csv, Entrenador1-SchDoc.kicad_pcb, Entrenador1-SchDoc.sch]
2018-03-25 Arreglos y ajuste
    [Entrenador1-SchDoc.csv, Lista_Materiales.ods]
2018-07-24 modified: Entrenador1-SchDoc.net modified: Entrenador1-SchDoc.sch Untracked files: Entrenador1-SchDoc_4Display_en_uno.kicad_pcb Entrenador1-SchDoc_4Display_en_uno.kicad_pcb-bak
    [Entrenador1-SchDoc.sch]
2018-07-24 Changes to be committed: new file: Entrenador1-SchDoc_4Display_en_uno.kicad_pcb new file: Entrenador1-SchDoc_4Display_en_uno.kicad_pcb-bak new file: Entrenador1-SchDoc_4Display_en_uno.pro
    [Entrenador1-SchDoc_4Display_en_uno.kicad_pcb]
2018-11-04 CAmbios en el conector USB aumento de los PADs On branch master Your branch is up to date with 'origin/master'.
    modified: libreria.pretty/USB_B.kicad_mod
    Untracked files:
    GerberOutput/Entrenador1-SchDoc_4Display_en_uno-Cmts.User.pdf
    GerberOutput/Entrenador1-SchDoc_4Display_en_uno-Dwgs.User.pdf
    GerberOutput/Entrenador1-SchDoc_4Display_en_uno-Edge.Cuts.pdf
    GerberOutput/Entrenador1-SchDoc_4Display_en_uno-F.Adhes.pdf
    GerberOutput/Entrenador1-SchDoc_4Display_en_uno-F.Cu.pdf
    GerberOutput/Entrenador1-SchDoc_4Display_en_uno-F.Mask.pdf
    GerberOutput/Entrenador1-SchDoc_4Display_en_uno-F.Paste.pdf
    GerberOutput/Entrenador1-SchDoc_4Display_en_uno-F.SilkS.pdf
    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
2018-11-04 Se modifica el conector USB para un mejor trabajo de los chicos
    [Entrenador1-SchDoc_4Display_en_uno.kicad_pcb]
2018-11-04 Actualización de la placa con nuevos componentes
    [Entrenador1-SchDoc_4Display_en_uno.kicad_pcb]
2018-11-19 new file: Gabinete2/basenameplate.gcode new file: Gabinete2/basenameplate.stl new file: Gabinete2/basenameplate.x3g new file: Gabinete2/letranegranameplate.stl new file: Gabinete2/nameplate.FCStd new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
    [basenameplate.stl, letranegranameplate.stl, nameplate.FCStd]
2018-11-19 new file: Gabinete2/Perilla.FCStd new file: Gabinete2/Perilla.FCStd1 new file: Gabinete2/PerillaCompleta001 (Meshed).stl modified: Gabinete2/nameplate.FCStd modified: Gabinete2/nameplate.FCStd1 new f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
    [Perilla.FCStd, perilla.stl, perilla2.stl]
2018-11-19 modified: Gabinete2/PerillaCompleta001 (Meshed).stl modified: Gabinete2/perilla.gcode modified: Gabinete2/perilla.x3g
2018-11-20 modified: Gabinete2/Perilla.FCStd modified: Gabinete2/Perilla.FCStd1
    [Perilla.FCStd]
2018-11-21 modified: Gabinete2/nameplate.FCStd modified: Gabinete2/nameplate.FCStd1 renamed: Gabinete2/perilla2.stl -> Gabinete2/perilla2lemos.stl renamed: Gabinete2/perilla.x3g -> Gabinete2/perillalemos.x3g
    [perilla2lemos.stl]
2019-06-22 Changes to be committed: modified: Gabinete2/basenameplate.stl new file: Gabinete2/letrabordes.stl modified: Gabinete2/letranegranameplate.stl modified: Gabinete2/nameplate.FCStd modified: Gabinete2/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
    [basenameplate.stl, letrabordes.stl, letranegranameplate.stl]
2019-06-22 modified: Entrenador1-SchDoc-cache.lib modified: Entrenador1-SchDoc-rescue.lib modified: Entrenador1-SchDoc.bak modified: Entrenador1-SchDoc.net modified: Entrenador1-SchDoc.pro modified: Entrenador1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
    [Entrenador1-SchDoc-2019-06-22-08-57-40.sch, Entrenador1-SchDoc_4Display_en_uno.kicad_pcb, Entrenador1-SchDoc_4Display_en_uno.sch]
2019-06-22 modified: Entrenador1-SchDoc_4Display_en_uno.bak modified: Entrenador1-SchDoc_4Display_en_uno.kicad_pcb modified: Entrenador1-SchDoc_4Display_en_uno.kicad_pcb-bak modified: Entrenador1-SchDoc_4Displa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
    [Entrenador1-SchDoc_4Display_en_uno.kicad_pcb, Entrenador1-SchDoc_4Display_en_uno.sch]
2019-06-22 modified: Entrenador1-SchDoc_4Display_en_uno-cache.lib modified: Entrenador1-SchDoc_4Display_en_uno.bak modified: Entrenador1-SchDoc_4Display_en_uno.kicad_pcb modified: Entrenador1-SchDoc_4Display_en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
    [Entrenador1-SchDoc_4Display_en_uno.kicad_pcb, Entrenador1-SchDoc_4Display_en_uno.sch]
2019-06-26 nuevo archivo: Entrenador1-SchDoc_4Display_en_uno-panel.kicad_pcb nuevo archivo: Entrenador1-SchDoc_4Display_en_uno-panel.kicad_pcb-bak nuevo archivo: Entrenador1-SchDoc_4Display_en_uno-panel.pro nue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
    [Entrenador1-SchDoc_4Display_en_uno-panel.kicad_pcb]
2019-12-28 Se realizaron cambios en el PCB respecto de los modelos 3D
    [Entrenador1-SchDoc_4Display_en_uno-panel.kicad_pcb, Entrenador1-SchDoc_4Display_en_uno.kicad_pcb]
2019-12-29 Ajuste de modelos step parte 1
    [Entrenador1-SchDoc_4Display_en_uno.kicad_pcb]
2019-12-29 Changes to be committed: modified: Entrenador1-SchDoc_4Display_en_uno.kicad_pcb modified: Entrenador1-SchDoc_4Display_en_uno.kicad_pcb-bak modified: Entrenador1-SchDoc_4Display_en_uno.step deleted: _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
    [Entrenador1-SchDoc_4Display_en_uno.kicad_pcb]
2019-12-29 Changes to be committed: modified: fp-info-cache modified: libreria.pretty/USB_B.kicad_mod
2019-12-31 deleted: Entrenador1-SchDoc.net modified: Entrenador1-SchDoc_4Display_en_uno-cache.lib modified: Entrenador1-SchDoc_4Display_en_uno.kicad_pcb modified: Entrenador1-SchDoc_4Display_en_uno.kicad_pcb-ba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
    [Entrenador1-SchDoc_4Display_en_uno.kicad_pcb]
2019-12-31 Changes to be committed: modified: Entrenador1-SchDoc_4Display_en_uno-cache.lib modified: Entrenador1-SchDoc_4Display_en_uno.kicad_pcb modified: Entrenador1-SchDoc_4Display_en_uno.kicad_pcb-bak modif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
    [Entrenador1-SchDoc_4Display_en_uno.kicad_pcb, Entrenador1-SchDoc_4Display_en_uno.sch]
2019-12-31 modified: Entrenador1-SchDoc_4Display_en_uno-cache.lib modified: Entrenador1-SchDoc_4Display_en_uno.kicad_pcb modified: Entrenador1-SchDoc_4Display_en_uno.kicad_pcb-bak modified: Entrenador1-SchDoc_4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
    [Entrenador1-SchDoc_4Display_en_uno.kicad_pcb, Entrenador1-SchDoc_4Display_en_uno.sch]
2019-12-31 deleted: rescue-backup/Entrenador1-SchDoc-2019-06-22-08-57-40.pro deleted: rescue-backup/Entrenador1-SchDoc-2019-06-22-08-57-40.sch deleted: rescue-backup/Entrenador1-SchDoc-cache-2019-06-22-08-57-40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
    [Entrenador1-SchDoc-2019-06-22-08-57-40.sch]
2020-01-16 new file: "Documentaci\303\263n/2020/Principal.tex" new file: "Documentaci\303\263n/2020/imagenes/Clasif_Semic-eps-converted-to.pdf" new file: "Documentaci\303\263n/2020/imagenes/Clasif_Semic.eps" ne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
    [potentiometer(RV16AF-41).SLDPRT, potentiometer(RV16AF-41).STEP]
2020-01-30 Changes to be committed: new file: "Documentaci\303\263n/2020/.~lock.ListaComponentes.csv#" modified: "Documentaci\303\263n/2020/Armado.aux" modified: "Documentaci\303\263n/2020/Armado.tex" new file: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
    [Entrenador1-SchDoc_4Display_en_uno (2).csv, Entrenador1-SchDoc_4Display_en_uno.csv, Entrenador1-SchDoc_4Display_en_uno.kicad_pcb, Entrenador1-SchDoc_4Display_en_uno.sch, ListaComponentes.csv]
2020-01-31 Changes to be committed: new file: Circuito2.sch deleted: "Documentaci\303\263n/2020/.~lock.ListaComponentes.csv#" modified: "Documentaci\303\263n/2020/Armado.aux" modified: "Documentaci\303\263n/202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
    [Circuito2.sch, Entrenador1-SchDoc.csv, Entrenador1-SchDoc_4Display_en_uno (2).csv, Entrenador1-SchDoc_4Display_en_uno.csv, Entrenador1-SchDoc_4Display_en_uno.kicad_pcb, Entrenador1-SchDoc_4Display_en_uno.sch, frente.FCStd, frente1.step]
2020-02-04 Changes to be committed: deleted: Circuito2.sch modified: "Documentaci\303\263n/2020/Armado.aux" modified: "Documentaci\303\263n/2020/Armado.tex" modified: "Documentaci\303\263n/2020/Principal.aux" m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
    [Circuito2.sch, Entrenador1-SchDoc_4Display_en_uno.kicad_pcb]
2020-02-09 Changes to be committed: new file: CAM/Entrenador2020.FlatPrj new file: "Documentaci\303\263n/2020/CAM_AcrilicoEntrenador_2.nc" new file: "Documentaci\303\263n/2020/CAM_AcrilicoEntrenador_3.nc" modif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
    [Entrenador1-SchDoc_4Display_en_uno.kicad_pcb, Entrenador1-SchDoc_4Display_en_uno.sch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]
