EEST1/Entrenador4to2018/(notices)

Notices in the files:
Modelos3d/CP_Radial_D6.3mm_P2.50mm.step:
Copyright (C) 2017, kicad StepUp
This program is free software: you can redistribute it and/or modify
it under the terms of the GNU General Public License as published by
the Free Software Foundation, either version 3 of the License, or
any later version.
itself might be covered by the GNU General Public License.
Modelos3d/PinHeader_1x03_P2.54mm_Vertical.step:
This work is licensed under the [Creative Commons CC-BY-SA 4.0 License](https://creativecommons.org/licenses/by-sa/4.0/legalcode),
with the following exception:
To the extent that the creation of electronic designs that use 'Licensed Material' can be considered to be 'Adapted Material',
You are free to use the library data in your own projects without the obligation to share your project files under this or any other license agreement.
Modelos3d/DIP-16_W7.62mm.step:
Copyright (C) 2017, your name
Modelos3d/PinSocket_1x08_P2.54mm_Vertical.step:
Copyright (C) 2017, Terje Io
This work is licensed under the Creative Commons CC-BY-SA 4.0 License with the following exception:
To the extent that the creation of electronic designs that use 'Licensed Material'
https://creativecommons.org/licenses/by-sa/4.0/legalcode
